ozeromer1111/hellen-example/docs/without-headers.png

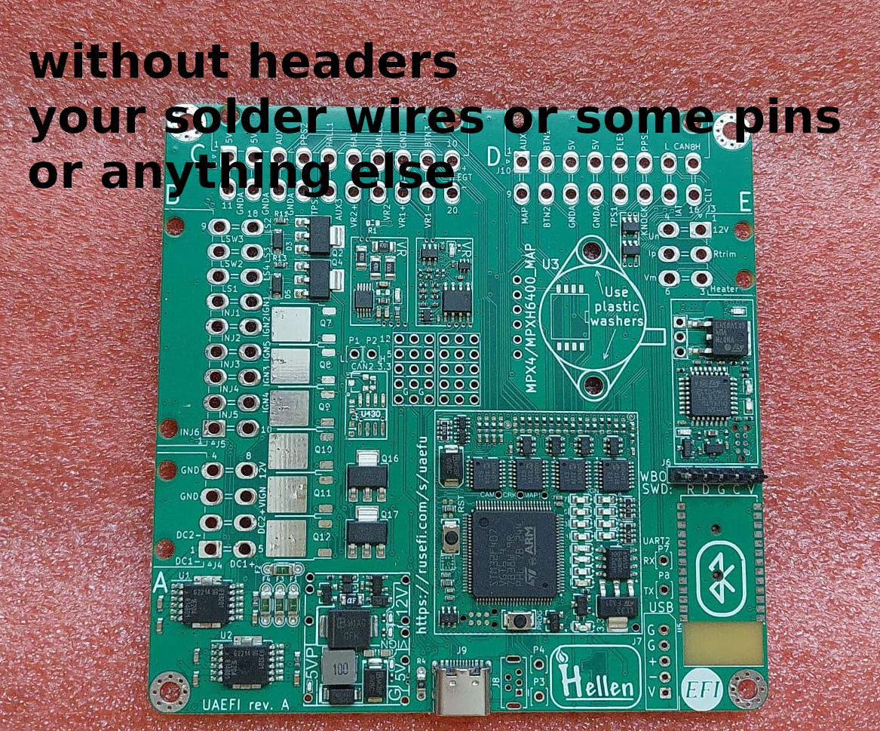
docs/without-headers.png
