ozeromer1111/hellen-example/docs/with-crimp-kit.jpg

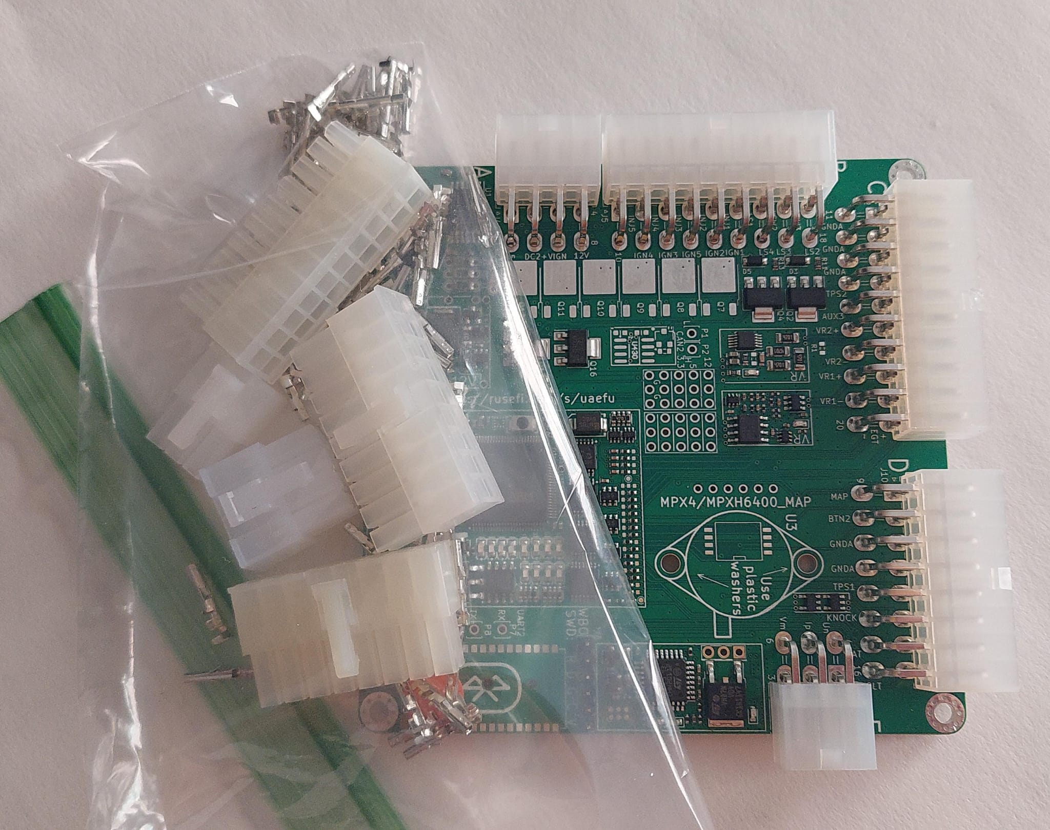
docs/with-crimp-kit.jpg
