ozeromer1111/hellen-example/boards/stabildaytona-v1/board/misc/stabildaytona-v1-bottom.png

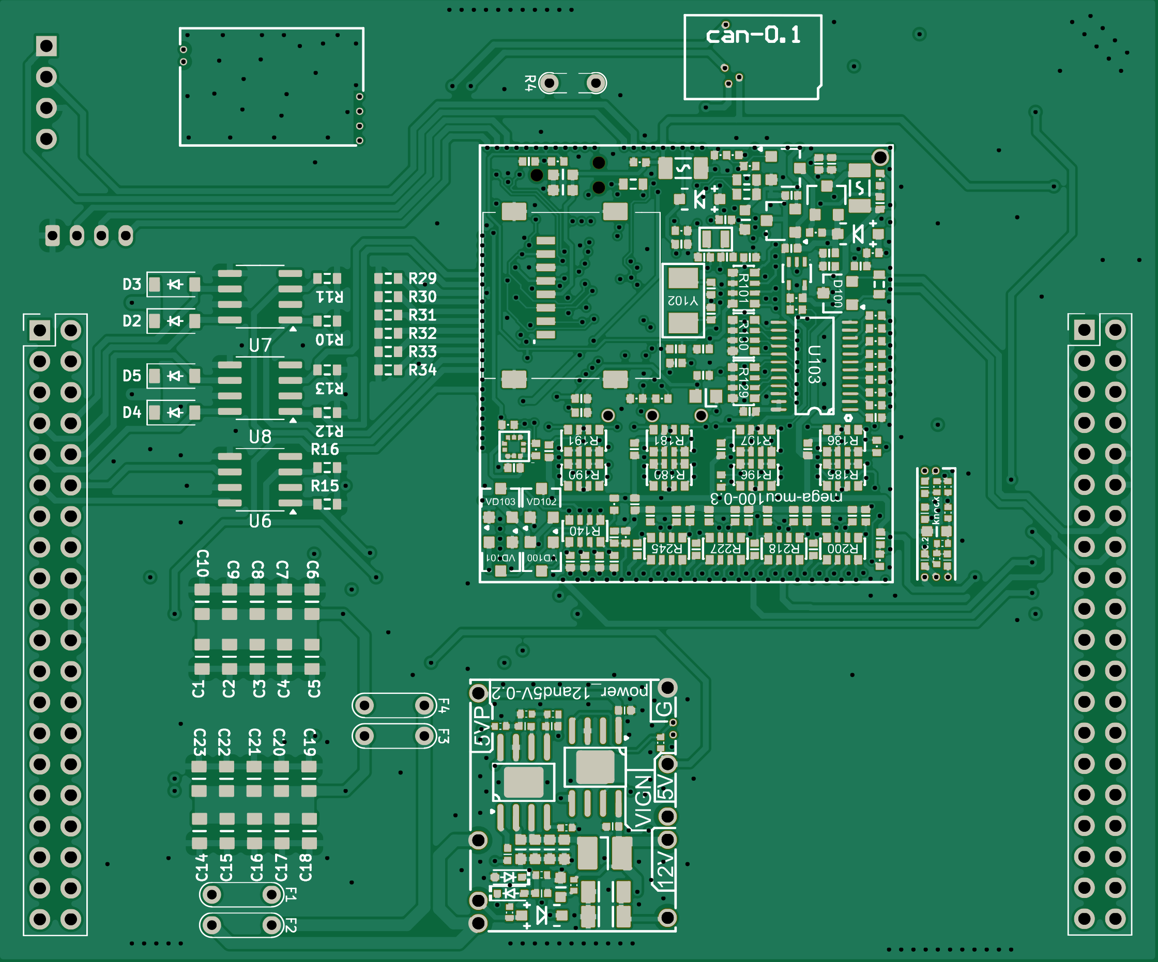
boards/stabildaytona-v1/board/misc/stabildaytona-v1-bottom.png
