ozeromer1111/hellen-example/boards/stabildaytona-v1/board/misc/stabildaytona-v1-top.png

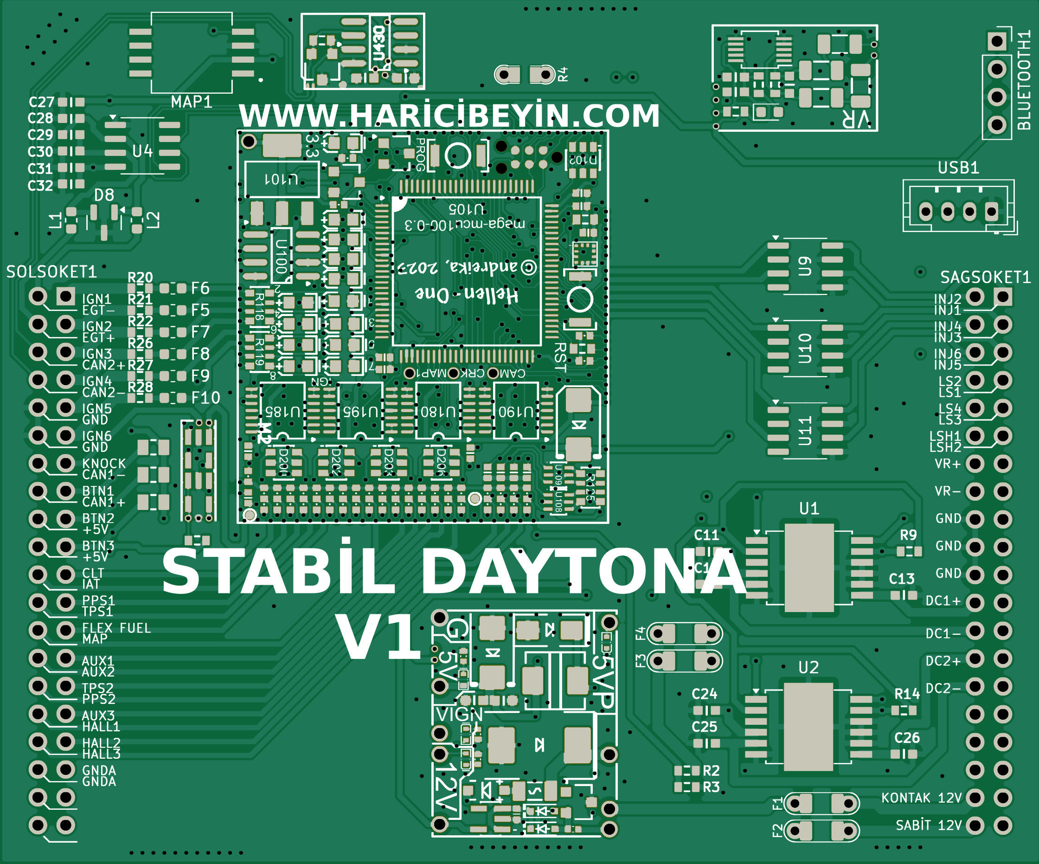
boards/stabildaytona-v1/board/misc/stabildaytona-v1-top.png
