ozeromer1111/hellen-example/boards/stabildaytona-v1/board/stabildaytona-v1.png

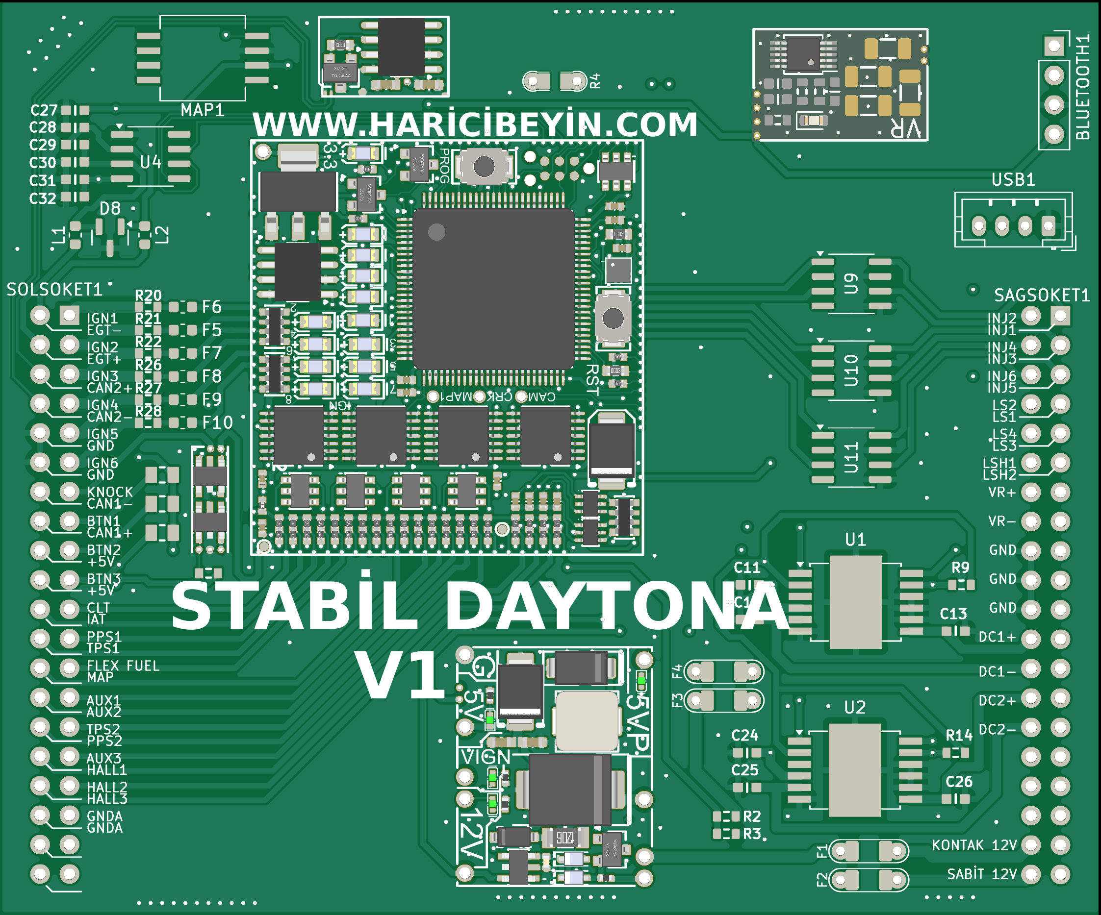
boards/stabildaytona-v1/board/stabildaytona-v1.png
