ozeromer1111/hellen-example/boards/uaefi-a/board/misc/uaefi-a-outline.png

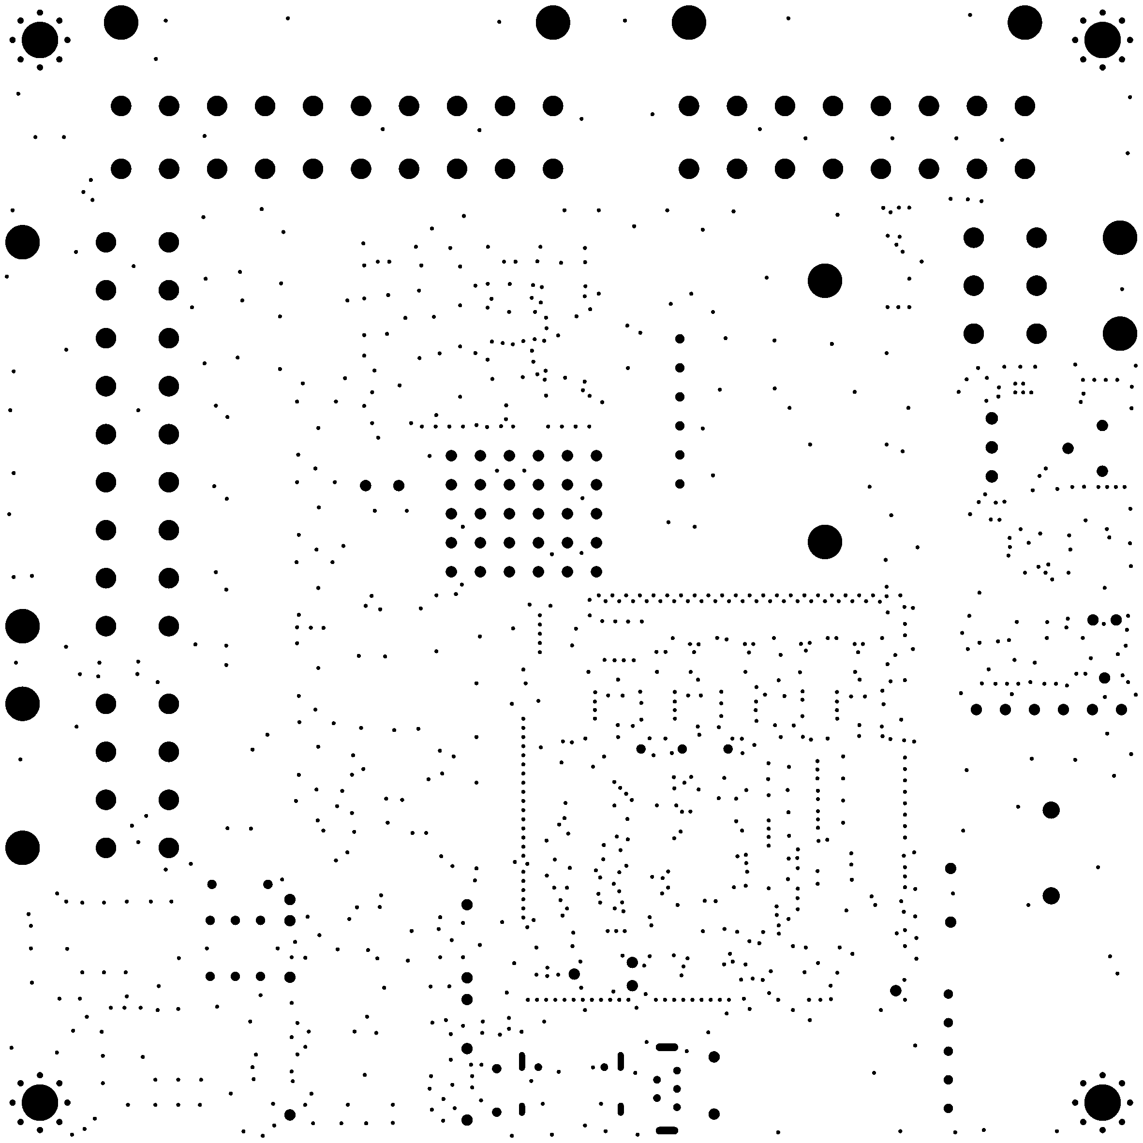
boards/uaefi-a/board/misc/uaefi-a-outline.png
