ozeromer1111/hellen-example/boards/uaefi-a/board/uaefi-a.png

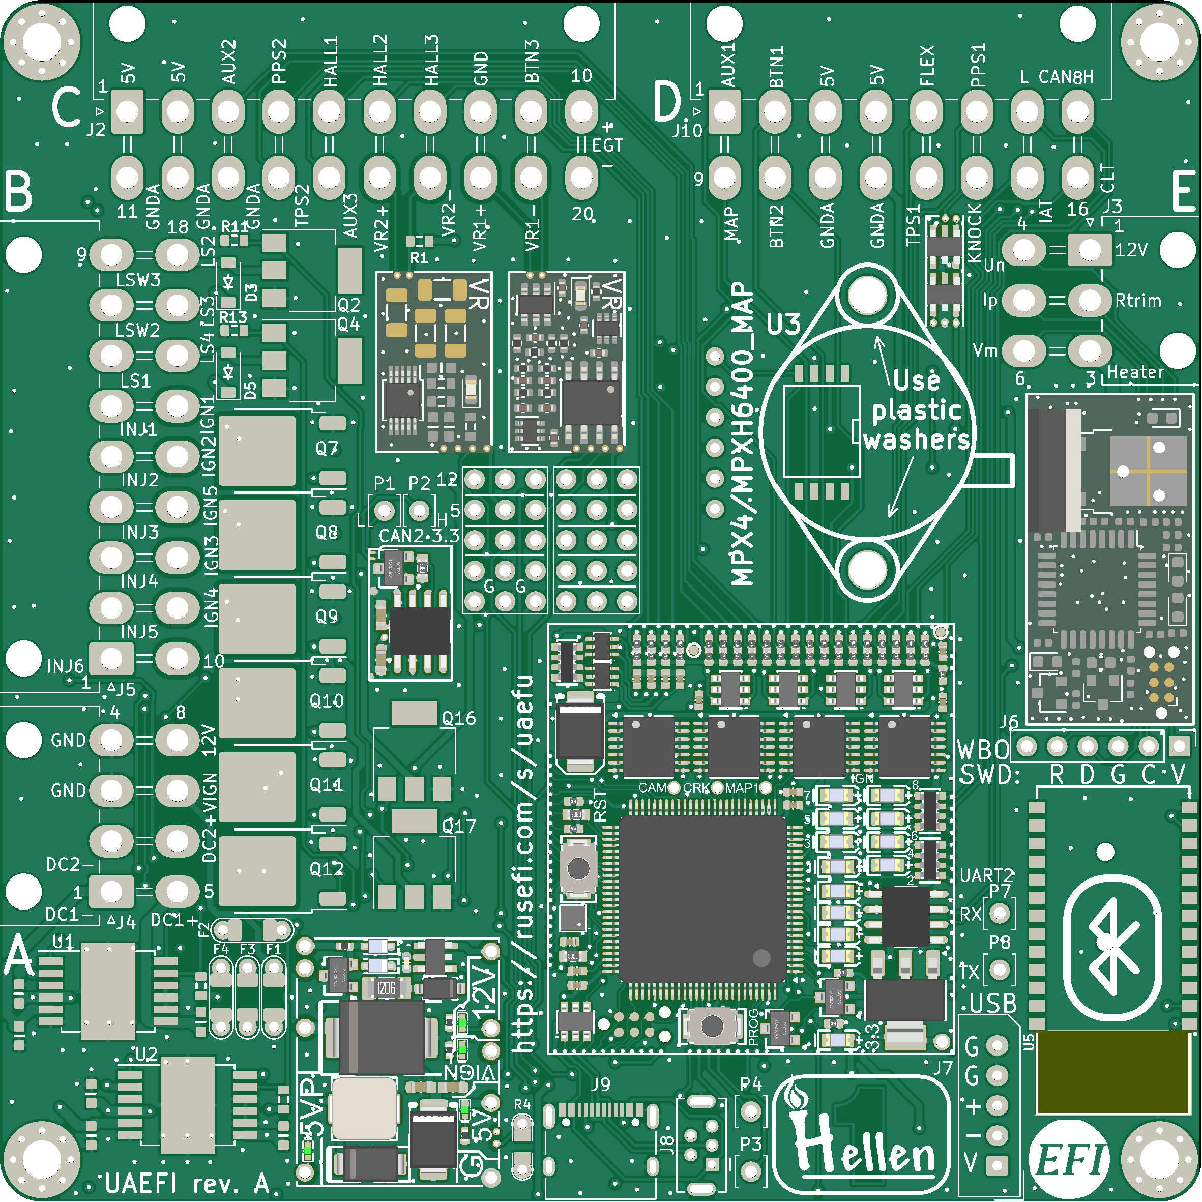
boards/uaefi-a/board/uaefi-a.png
