ozeromer1111/hellen-example/boards/uaefi-b/board/misc/uaefi-b-bottom.png

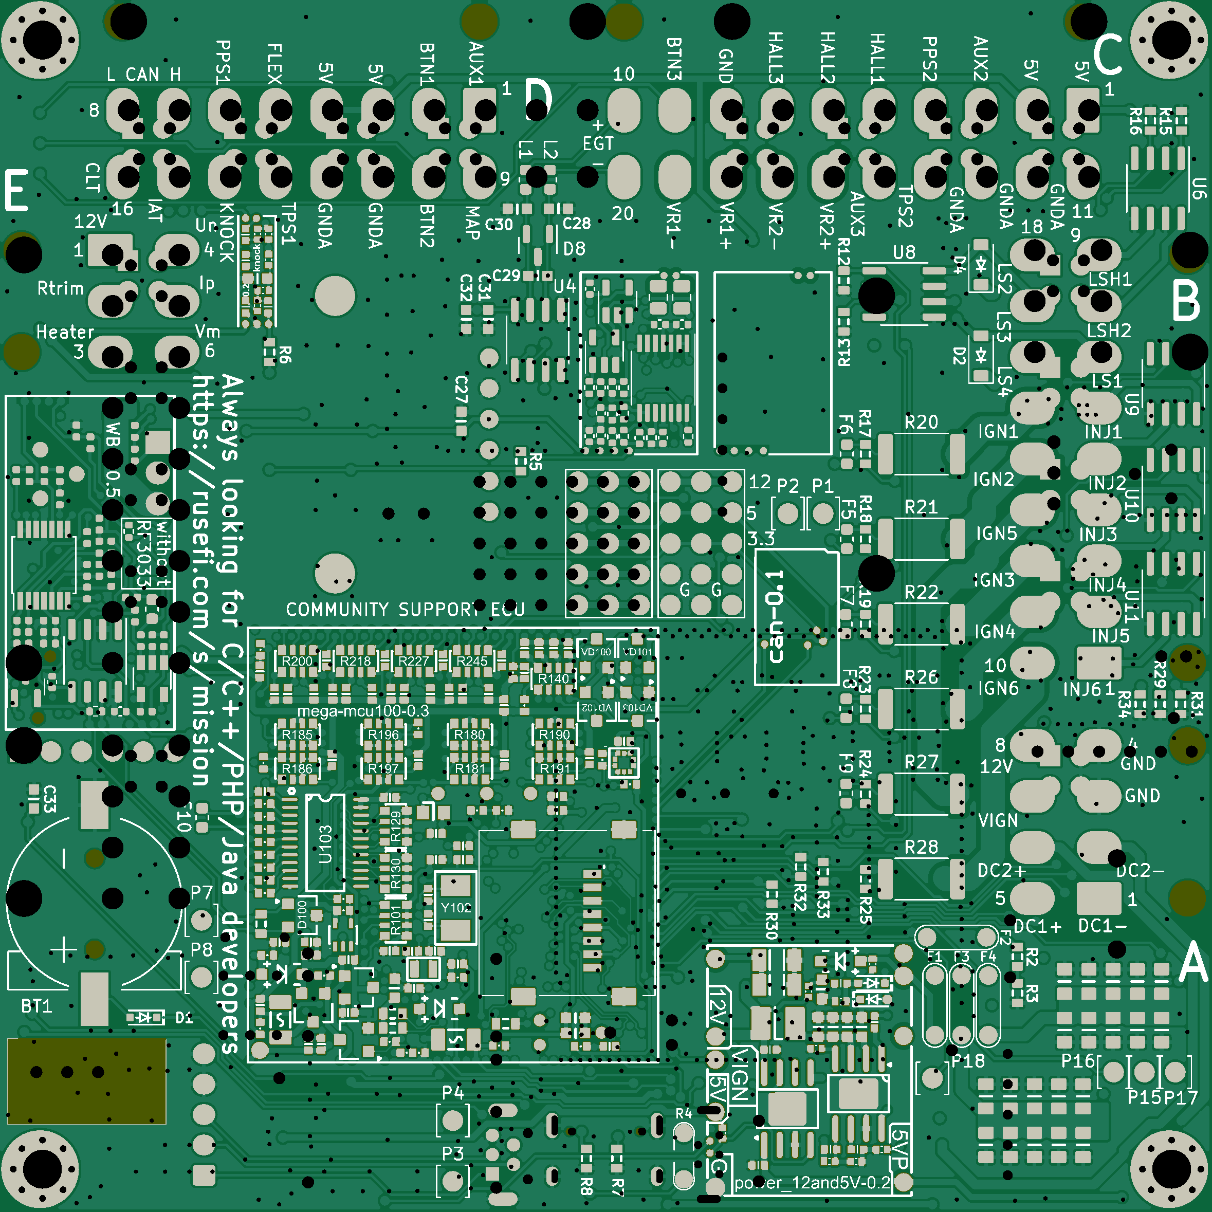
boards/uaefi-b/board/misc/uaefi-b-bottom.png
