ozeromer1111/hellen-example/boards/uaefi-b/board/misc/uaefi-b-top.png

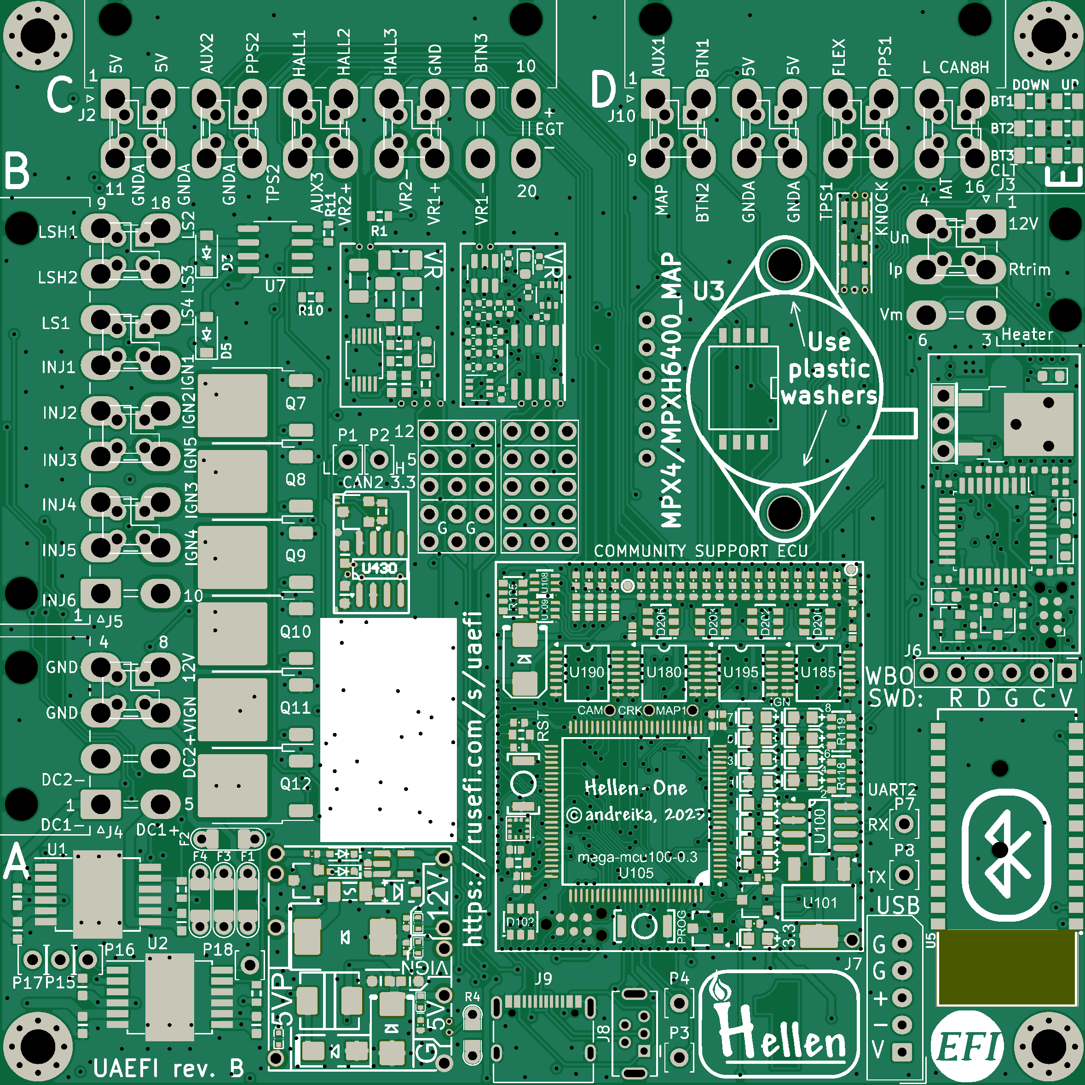
boards/uaefi-b/board/misc/uaefi-b-top.png
