ozeromer1111/hellen-example/boards/uaefi-b/board/uaefi-b.png

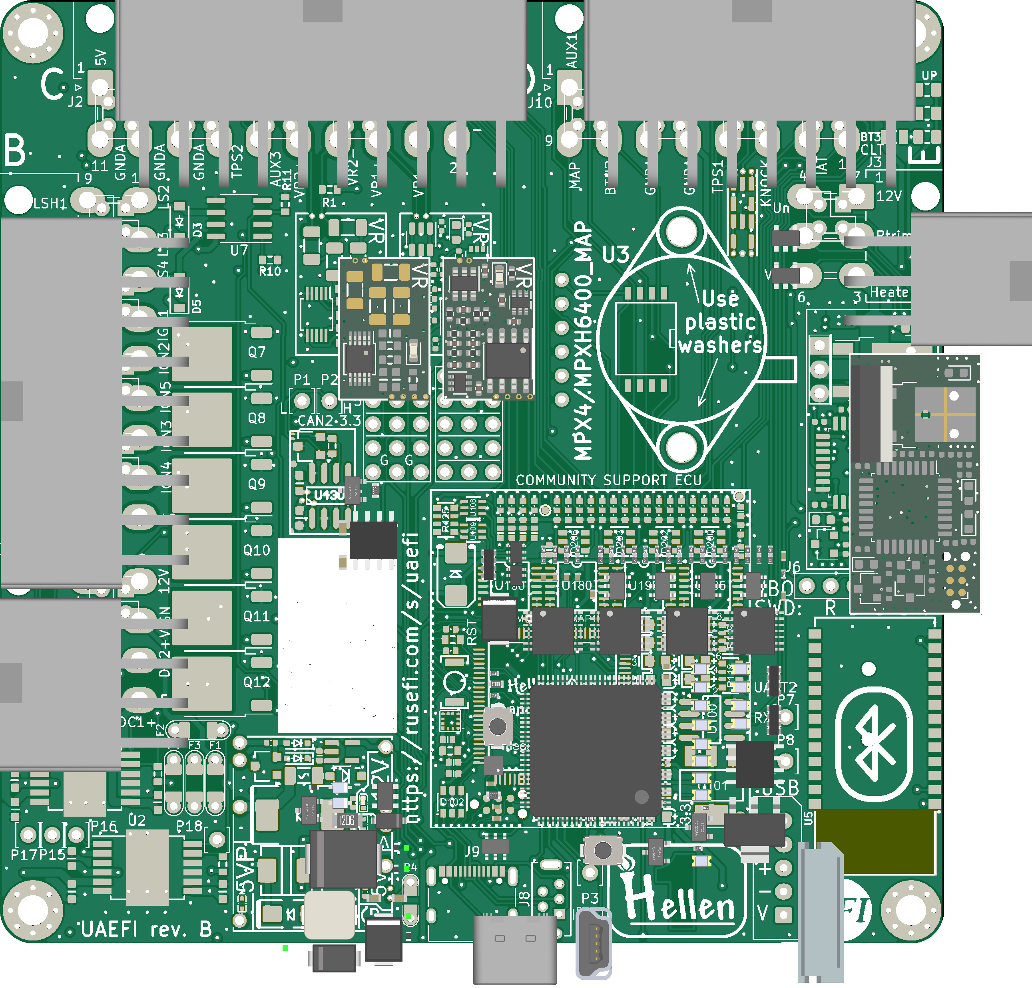
boards/uaefi-b/board/uaefi-b.png
