ozeromer1111/hellen-example/boards/uaefi-c/board/misc/uaefi-c-bottom.png

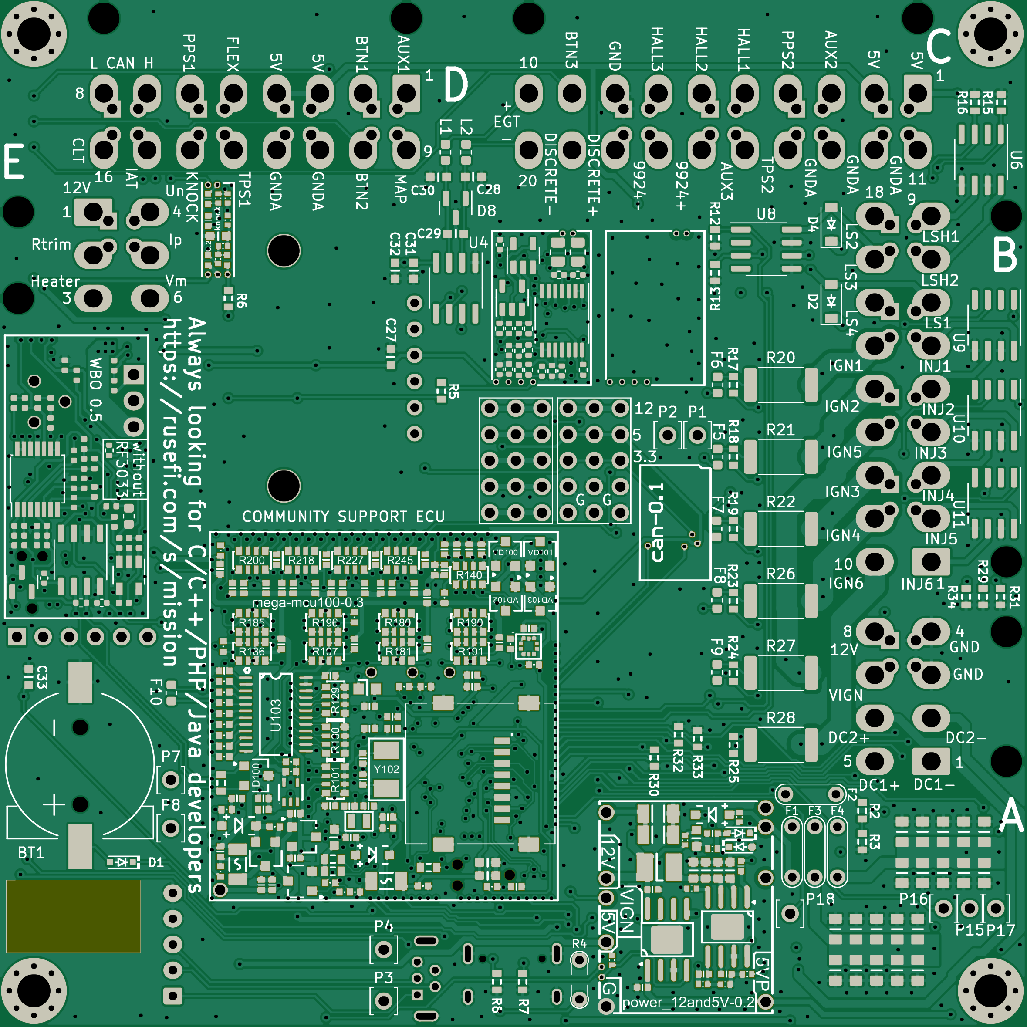
boards/uaefi-c/board/misc/uaefi-c-bottom.png
