ozeromer1111/hellen-example/boards/uaefi-d/board/uaefi-d.png

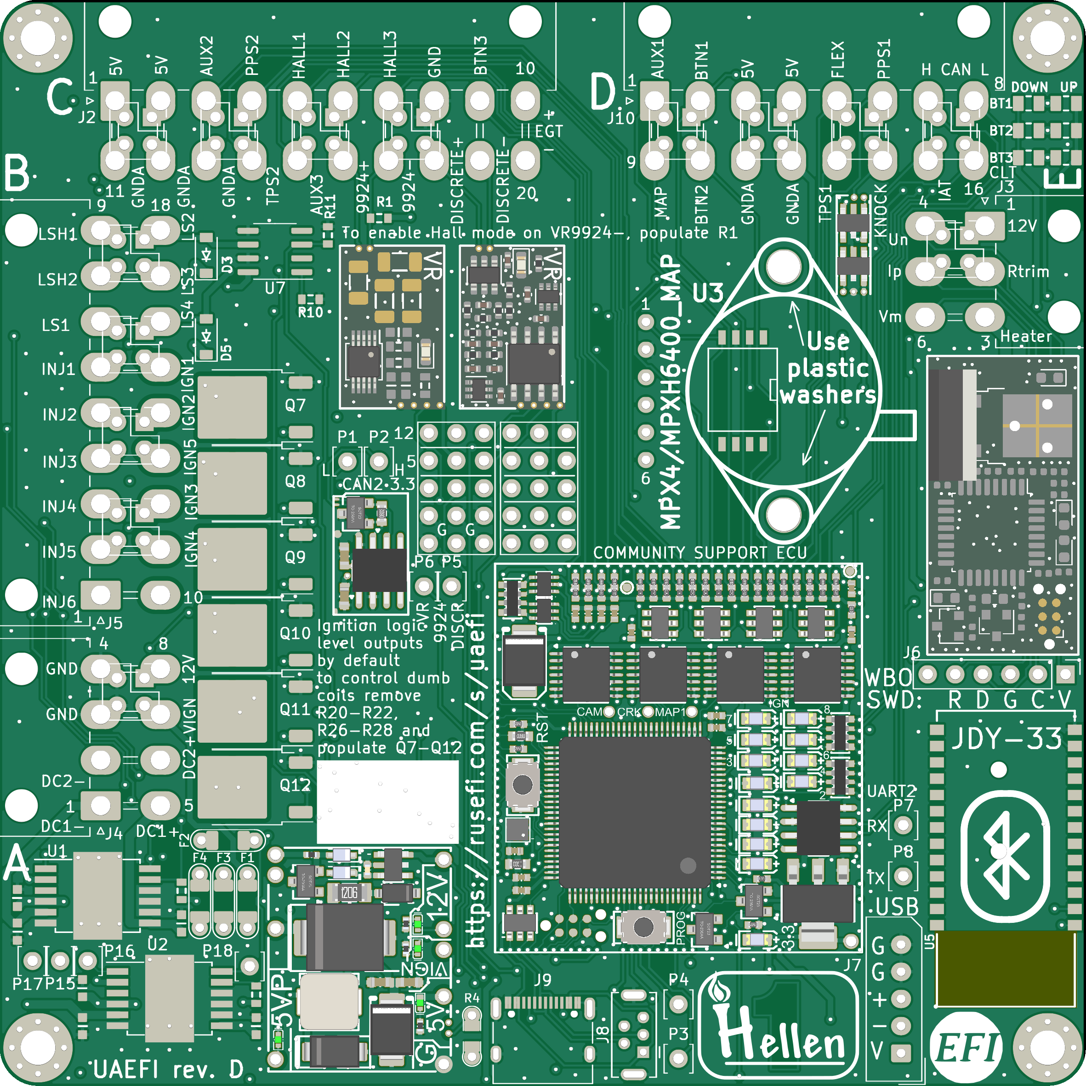
boards/uaefi-d/board/uaefi-d.png
