ozeromer1111/hellen-example/docs/base-bottom.jpg

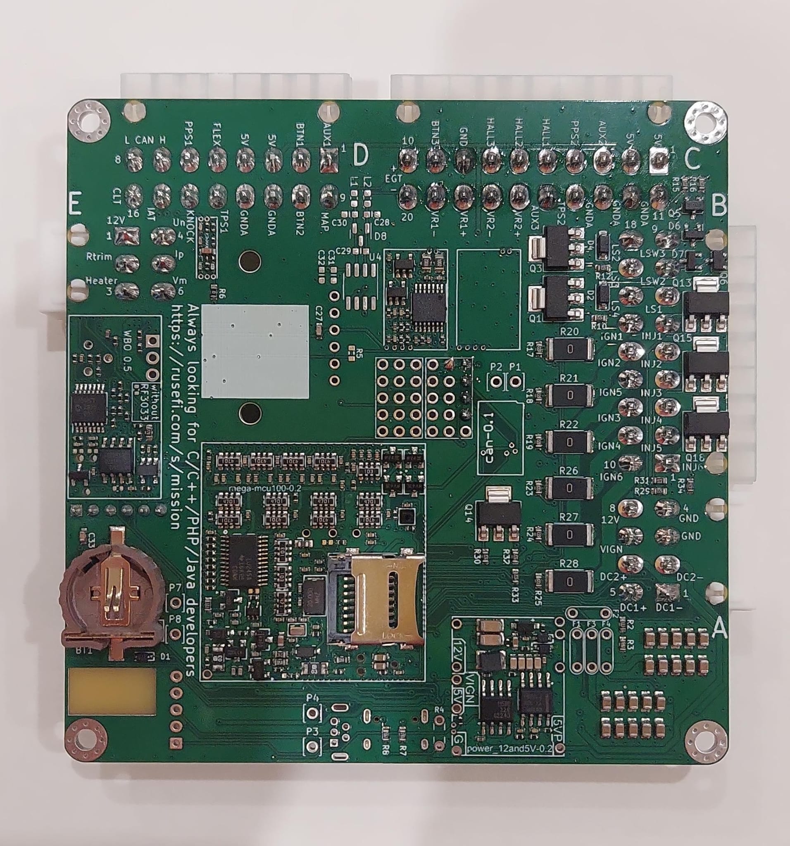
docs/base-bottom.jpg
