ozeromer1111/hellen-example/docs/base-top.jpg

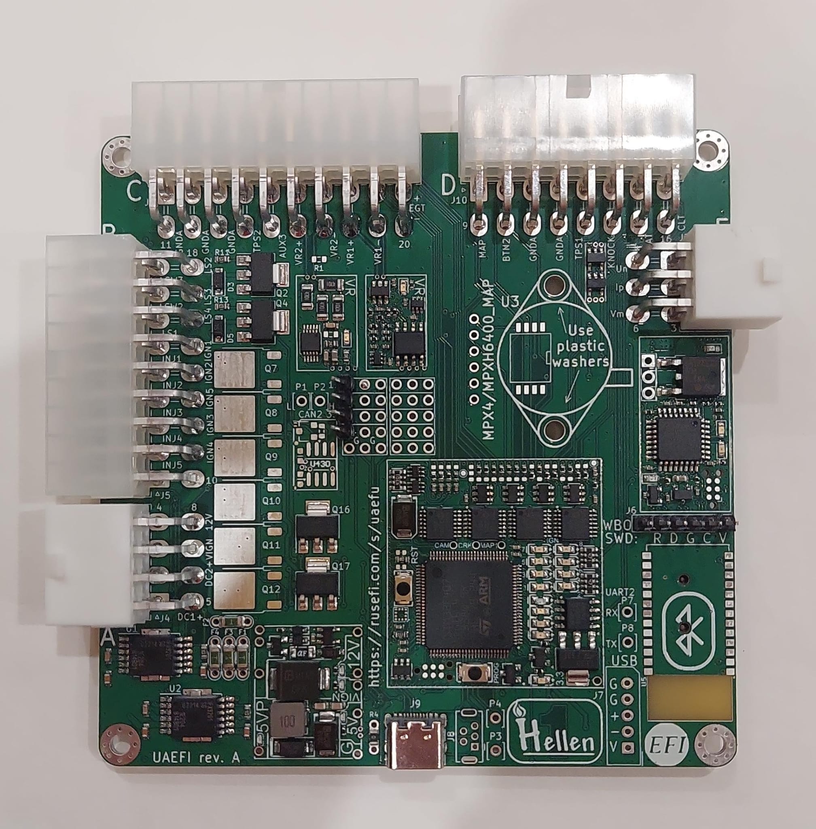
docs/base-top.jpg
