ozeromer1111/hellen-example/docs/orange-150.jpg

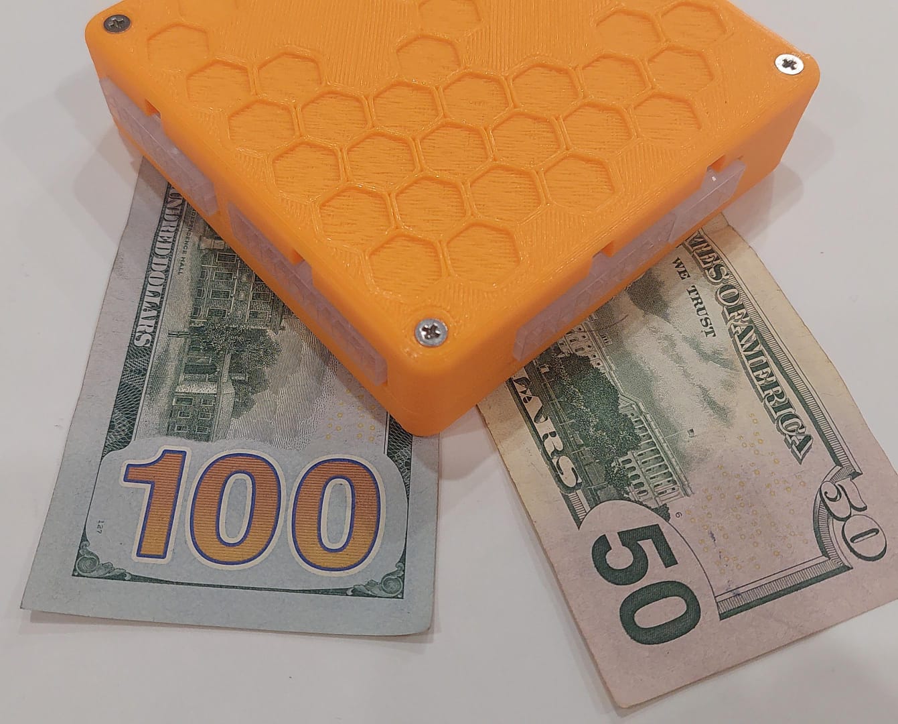
docs/orange-150.jpg
