ozeromer1111/hellen-example/docs/orange.jpg

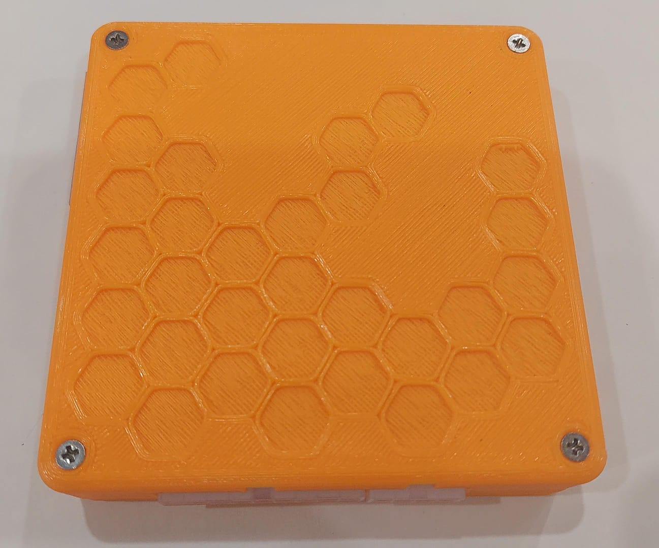
docs/orange.jpg
