ozeromer1111/hellen-example/docs/premium-bottom.jpg

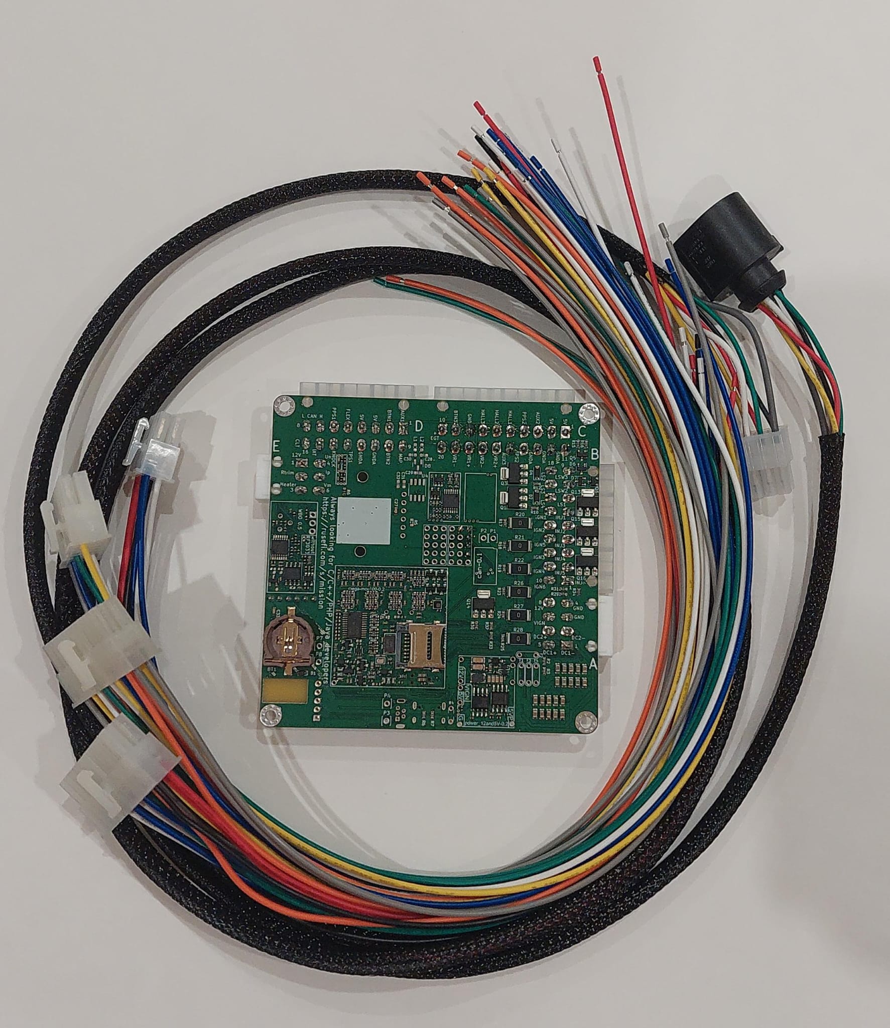
docs/premium-bottom.jpg
