ozeromer1111/hellen-example/docs/premium-top.jpg

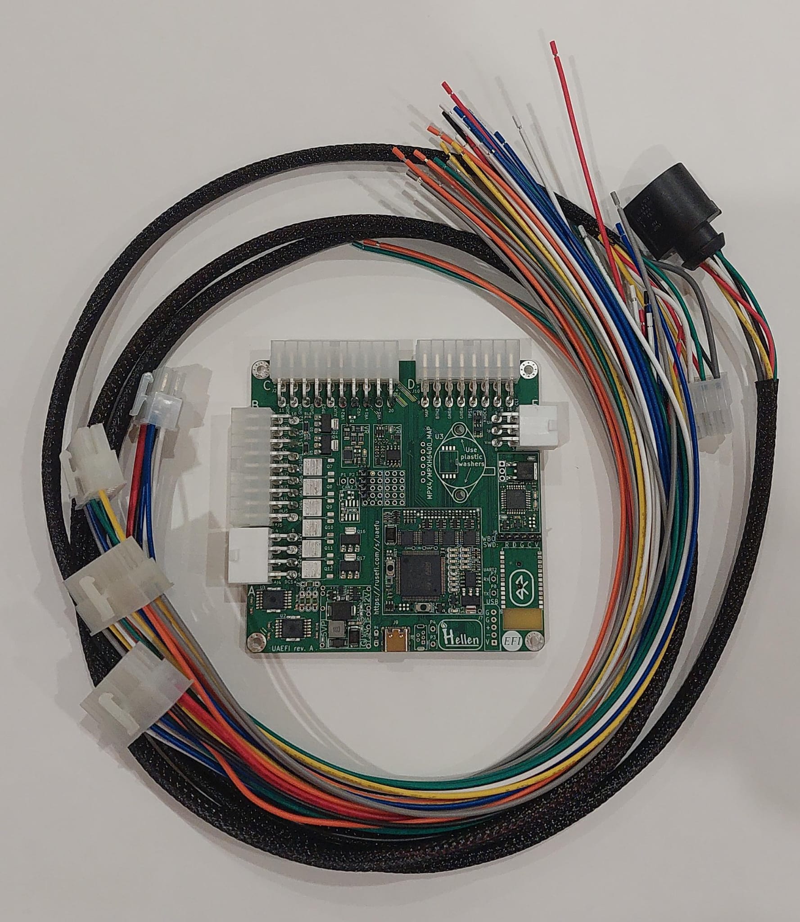
docs/premium-top.jpg
