ozeromer1111/hellen-example/docs/uaefi-a-top-high-res.jpg

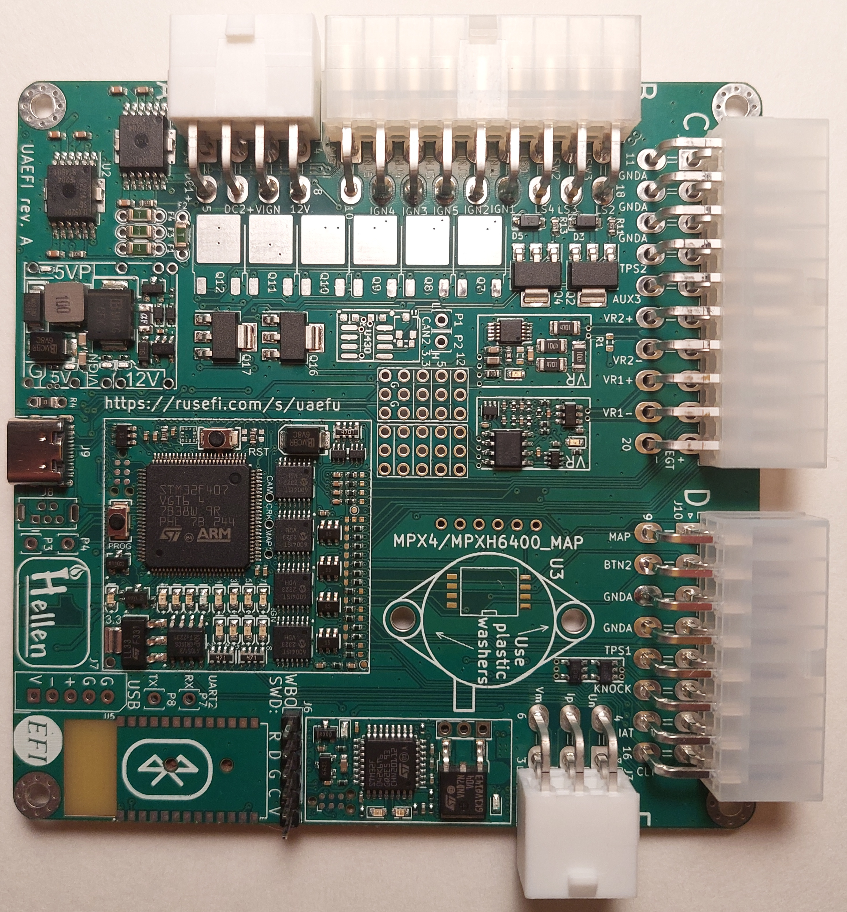
docs/uaefi-a-top-high-res.jpg
