ozeromer1111/hellen-example/docs/with-headers.png

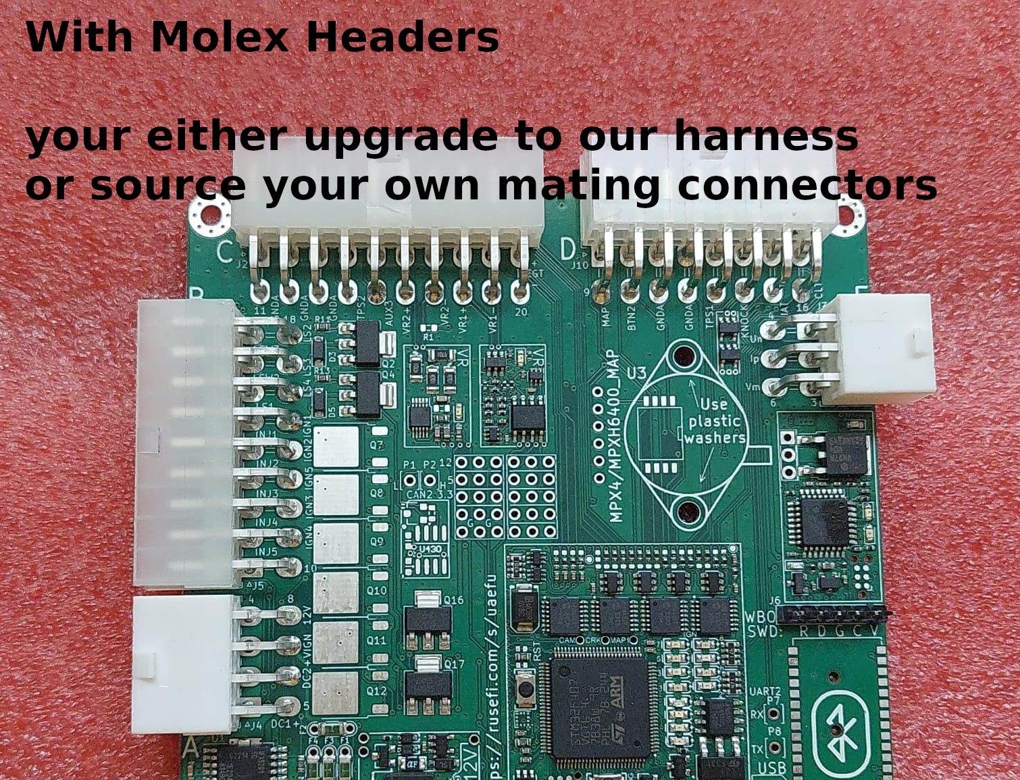
docs/with-headers.png
