ozeromer1111/hellen-example/boards/uaefi-a/board/misc/uaefi-a-components.png

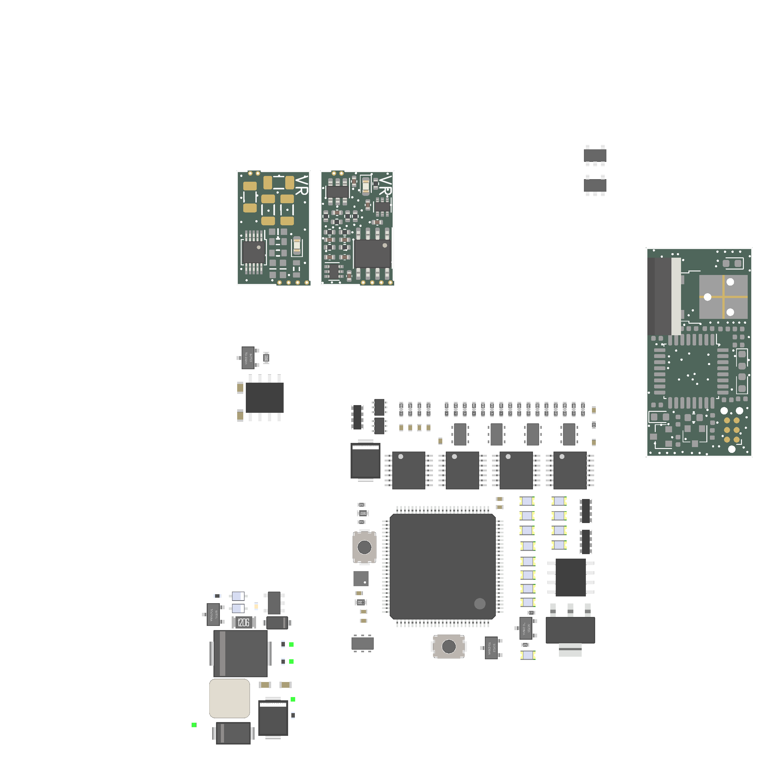
boards/uaefi-a/board/misc/uaefi-a-components.png
