ozeromer1111/hellen-example/boards/uaefi-b/board/misc/uaefi-b-components.png

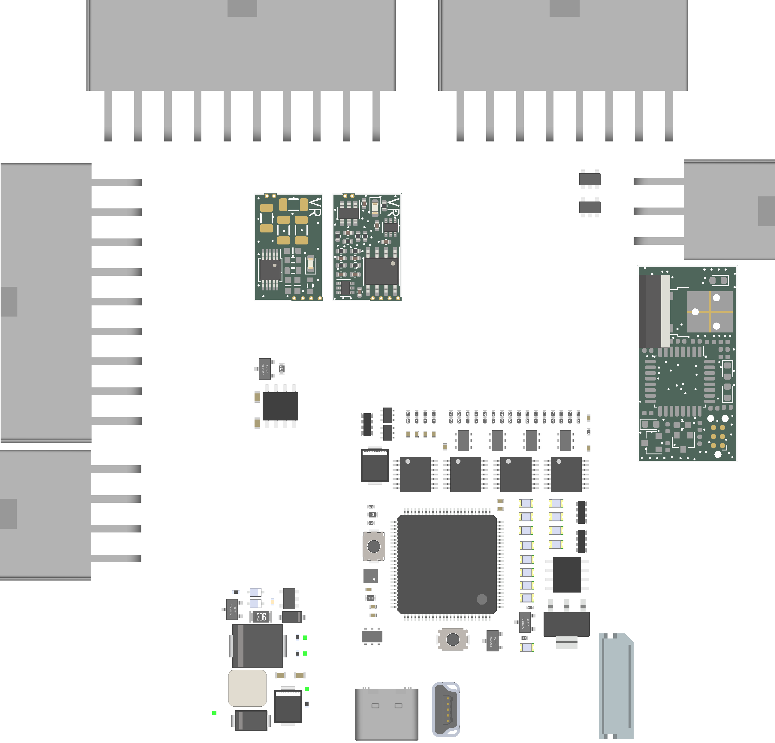
boards/uaefi-b/board/misc/uaefi-b-components.png
