ozeromer1111/hellen-example/3D models/User Library-UE25BE5510H.STEP

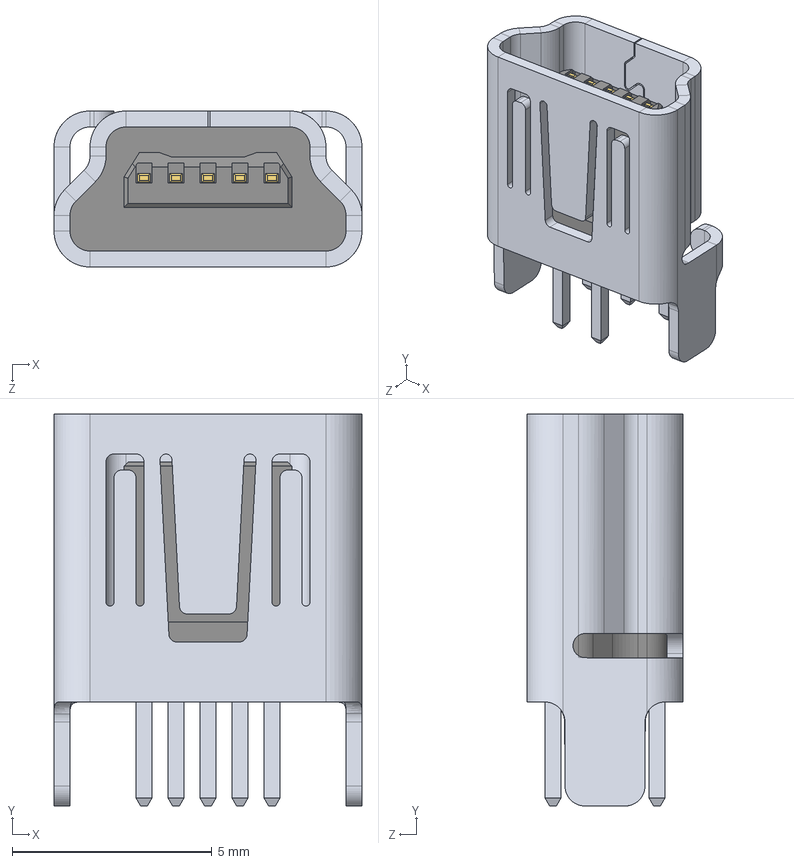
[picture p43: CAD file, 2024-12-31]
3D models/User Library-UE25BE5510H.STEP
7.70 x 9.80 x 3.90 mm
