ozeromer1111/hellen-example/3D models/User Library-USB-B-Vert-MINI.STEP

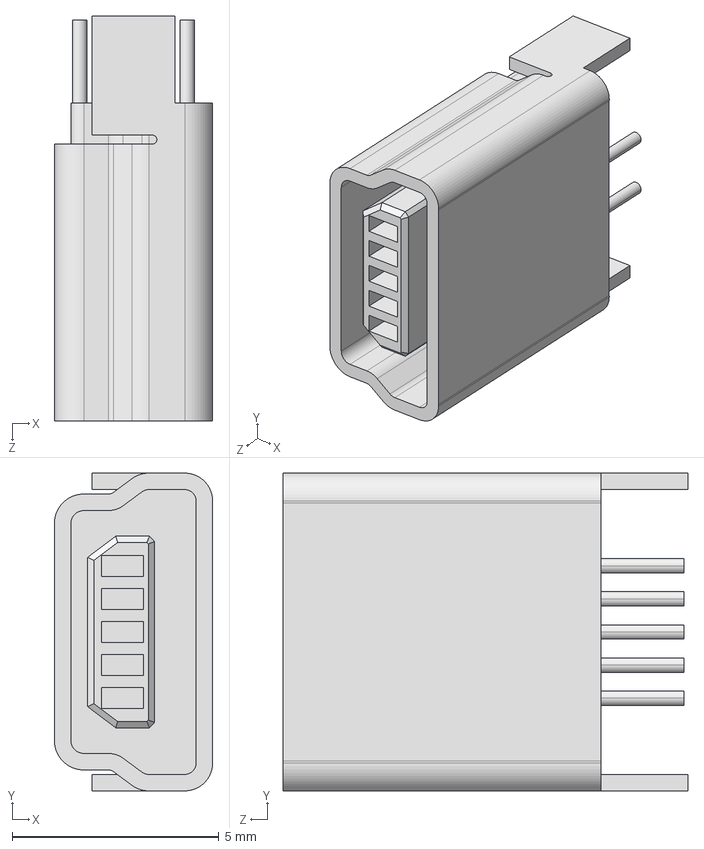
[picture p44: CAD file, 2024-12-31]
3D models/User Library-USB-B-Vert-MINI.STEP
3.83 x 7.69 x 9.80 mm
