ozeromer1111/hellen-example/3D models/User Library-USB - C.STEP

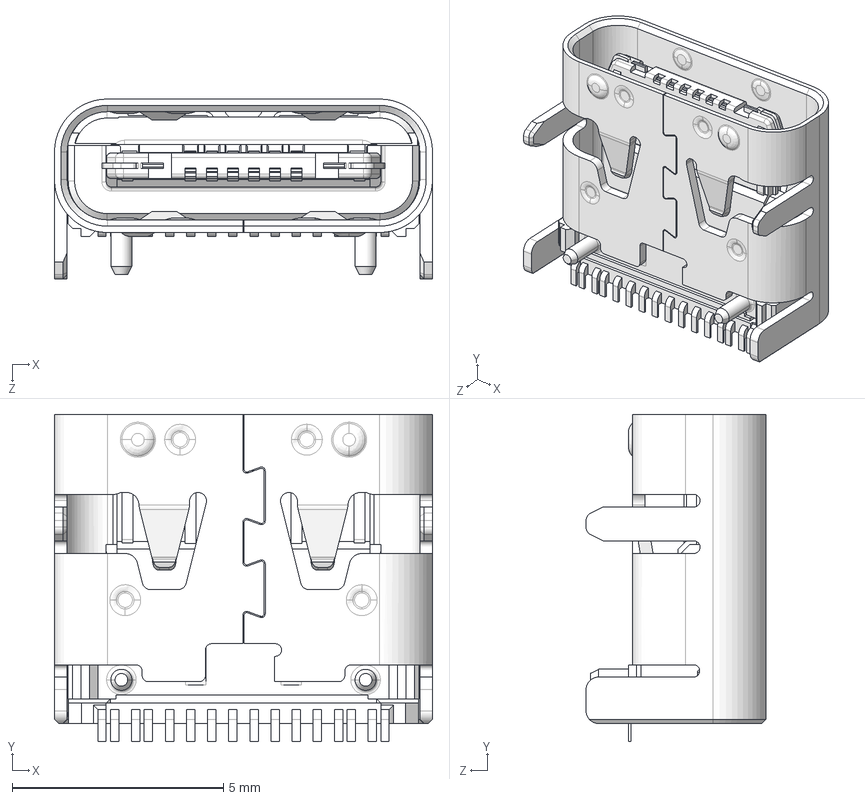
[picture p45: CAD file, 2024-12-31]
3D models/User Library-USB - C.STEP
8.95 x 7.75 x 4.26 mm
