ozeromer1111/hellen-example/3D models/022035055.stp

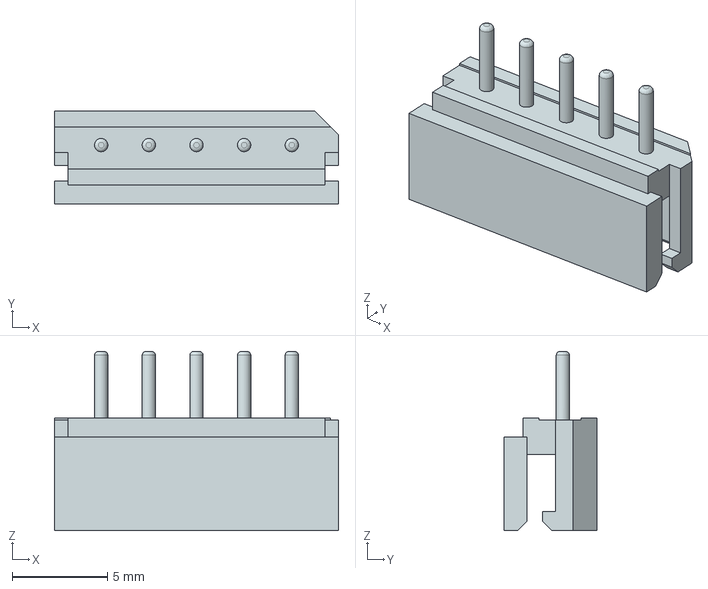
[picture p46: CAD file, 2024-12-31]
3D models/022035055.stp
14.9 x 4.90 x 9.40 mm
