ozeromer1111/hellen-example/3D models/039301060.stp

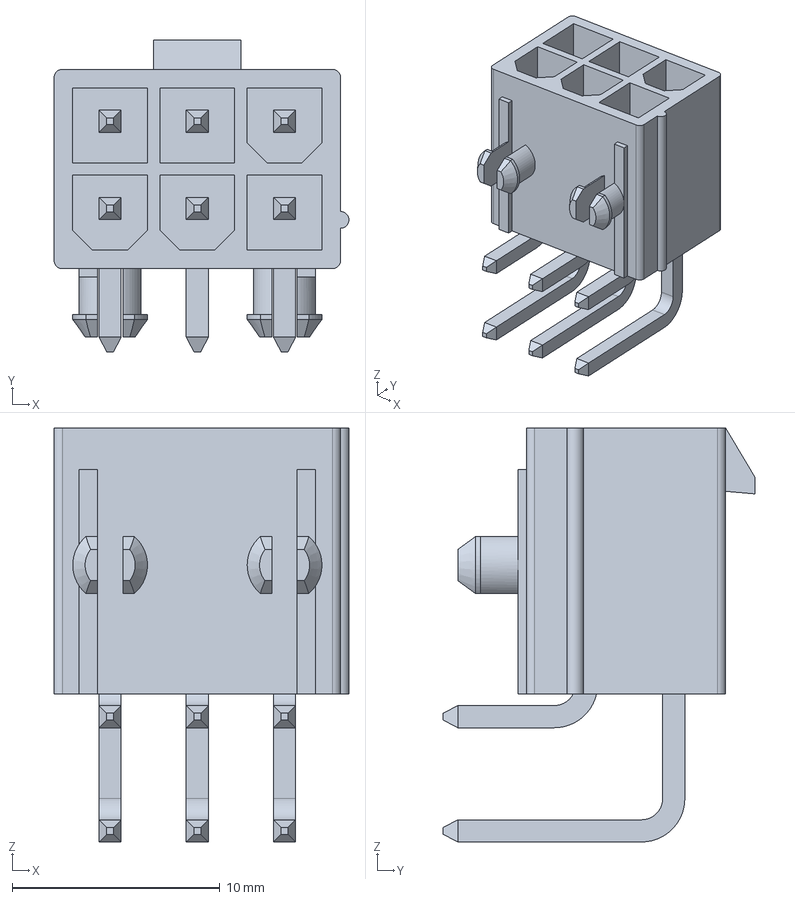
[picture p47: CAD file, 2024-12-31]
3D models/039301060.stp
14.2 x 15.0 x 19.9 mm
