ozeromer1111/hellen-example/3D models/039301200.stp

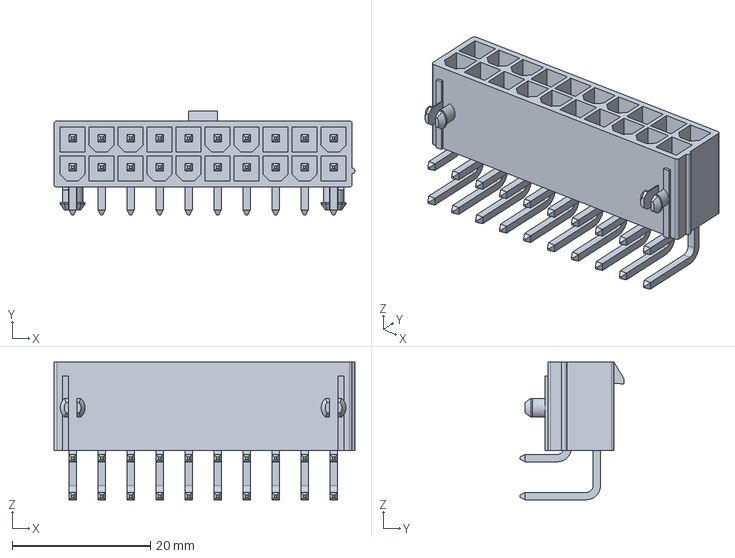
[picture p48: CAD file, 2024-12-31]
3D models/039301200.stp
43.6 x 15.0 x 19.9 mm
