ozeromer1111/hellen-example/3D models/039301180.stp

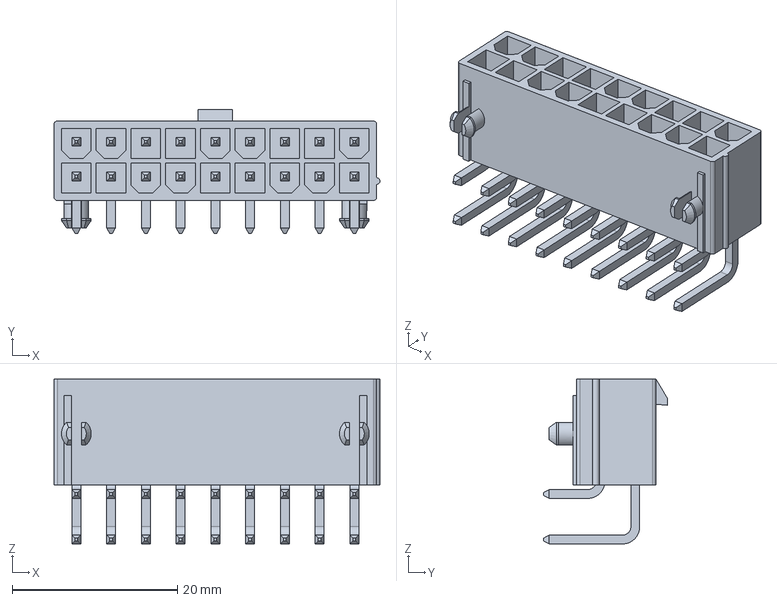
[picture p49: CAD file, 2024-12-31]
3D models/039301180.stp
39.4 x 15.0 x 19.9 mm
