ozeromer1111/hellen-example/3D models/039301160.stp

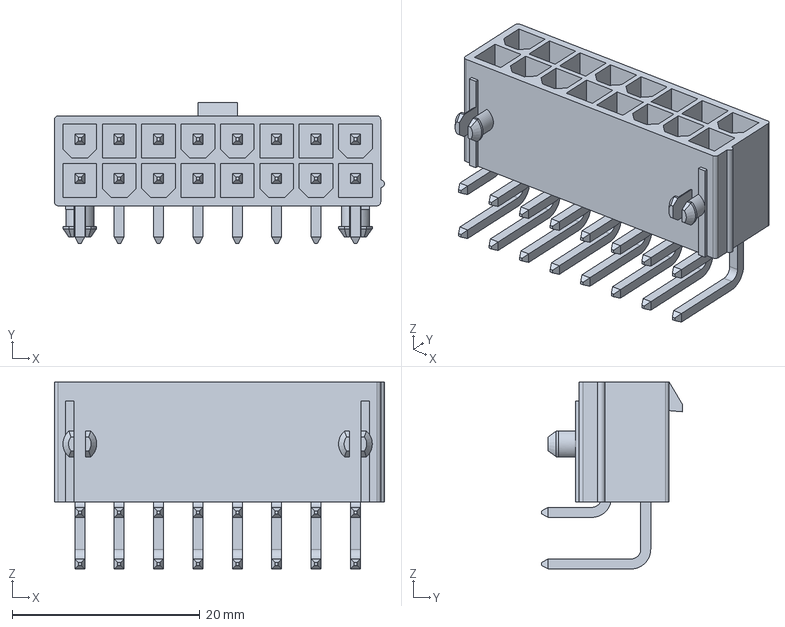
[picture p50: CAD file, 2024-12-31]
3D models/039301160.stp
35.2 x 15.0 x 19.9 mm
