ozeromer1111/hellen-example/3D models/039301080.stp

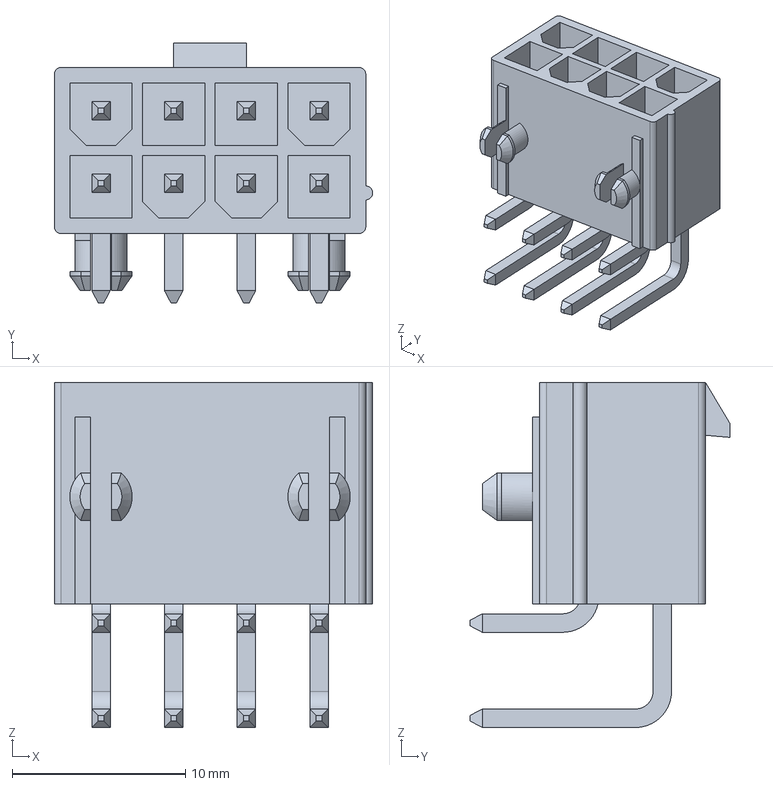
[picture p51: CAD file, 2024-12-31]
3D models/039301080.stp
18.4 x 15.0 x 19.9 mm
