ozeromer1111/hellen-example/3D models/1054500101.stp

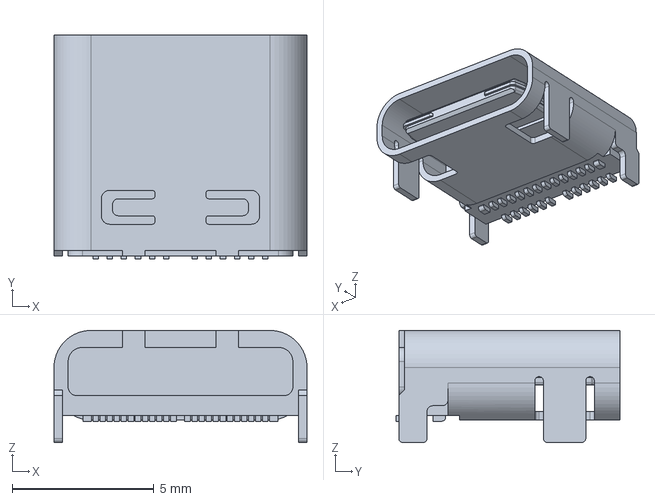
[picture p52: CAD file, 2024-12-31]
3D models/1054500101.stp
8.94 x 7.90 x 3.96 mm
