ozeromer1111/hellen-example/boards/stabildaytona-v1/frame/daytona-schematic.pdf

https://rusefi.com/s/uaefi
Id: 1/9 Title: UAEFI File: stabildaytona.kicad_sch Sheet: / rusEFI.com



Id: 3/9 Title: UAEFI File: LS4.kicad_sch Sheet: /LS/ rusEFI.com




Id: 8/9 Title: UAEFI File: MAP.kicad_sch Sheet: /MAP/ rusEFI.com


Id: 9/9 Title: UAEFI File: IGN6.kicad_sch Sheet: /Ignition/ rusEFI.com


Id: 9/9 Title: UAEFI File: egt.kicad_sch Sheet: /EGT/ rusEFI.com GND
