ozeromer1111/hellen-example/boards/uaefi-a/frame/efi-schematic.pdf

LS & HS outputs Discrete inputs

Analog/digital Heater negative Power GND

3V3 12 GND 13 EN 15 ALED 16 STAT 17 RXD 2

enable the CAN WAKEUP
input will be unavailable.

use ADC3 for receiving
the analog signal VR1
instead of the knock
signal

https://rusefi.com/s/h112-17
File: uaefi.kicad_sch Sheet: / rusEFI.com



File: LS4.kicad_sch Sheet: /Low Side 2A/ rusefi.com

Id: 3/9 Title: UAEFI Low Side


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


Id: 8/9 Title: File: MAP.kicad_sch Sheet: /MAP/


File: IGN6.kicad_sch Sheet: /Ignition/ rusefi.com

Id: 9/9 Title: UAEFI Ignition


4 SCK 5 ~{CS}6 SO 7 U4 MAX31855KASA DNP

Id: 9/9 Title: File: egt.kicad_sch Sheet: /EGT/


Id: 10/9 Title: UAEFI Injector File: INJ6.kicad_sch Sheet: /Injector/ rusefi.com
