ozeromer1111/hellen-example/boards/uaefi-c/frame/efi-schematic.pdf

Analog/digital Heater negative Power GND

3V3 12 GND 13 EN 15 ALED 16 STAT 17 RXD 2

enable the CAN WAKEUP
input will be unavailable.

analog signal VR-DISCRETE
instead of the knock signal

Hellen-One-PCB-logo

https://rusefi.com/s/uaefi
Id: 1/9 Title: UAEFI File: uaefi.kicad_sch Sheet: / rusEFI.com



File: LS4.kicad_sch Sheet: /LS/ rusefi.com

Id: 3/9 Title: UAEFI Low Side




Id: 8/9 Title: File: MAP.kicad_sch Sheet: /MAP/


File: IGN6.kicad_sch Sheet: /Ignition/ rusefi.com

Id: 9/9 Title: UAEFI Ignition


Id: 9/9 Title: File: egt.kicad_sch Sheet: /EGT/
