ozeromer1111/hellen-example/stabildaytona.kicad_pcb

## KiCad design stabildaytona.kicad_pcb (2025-04-19)

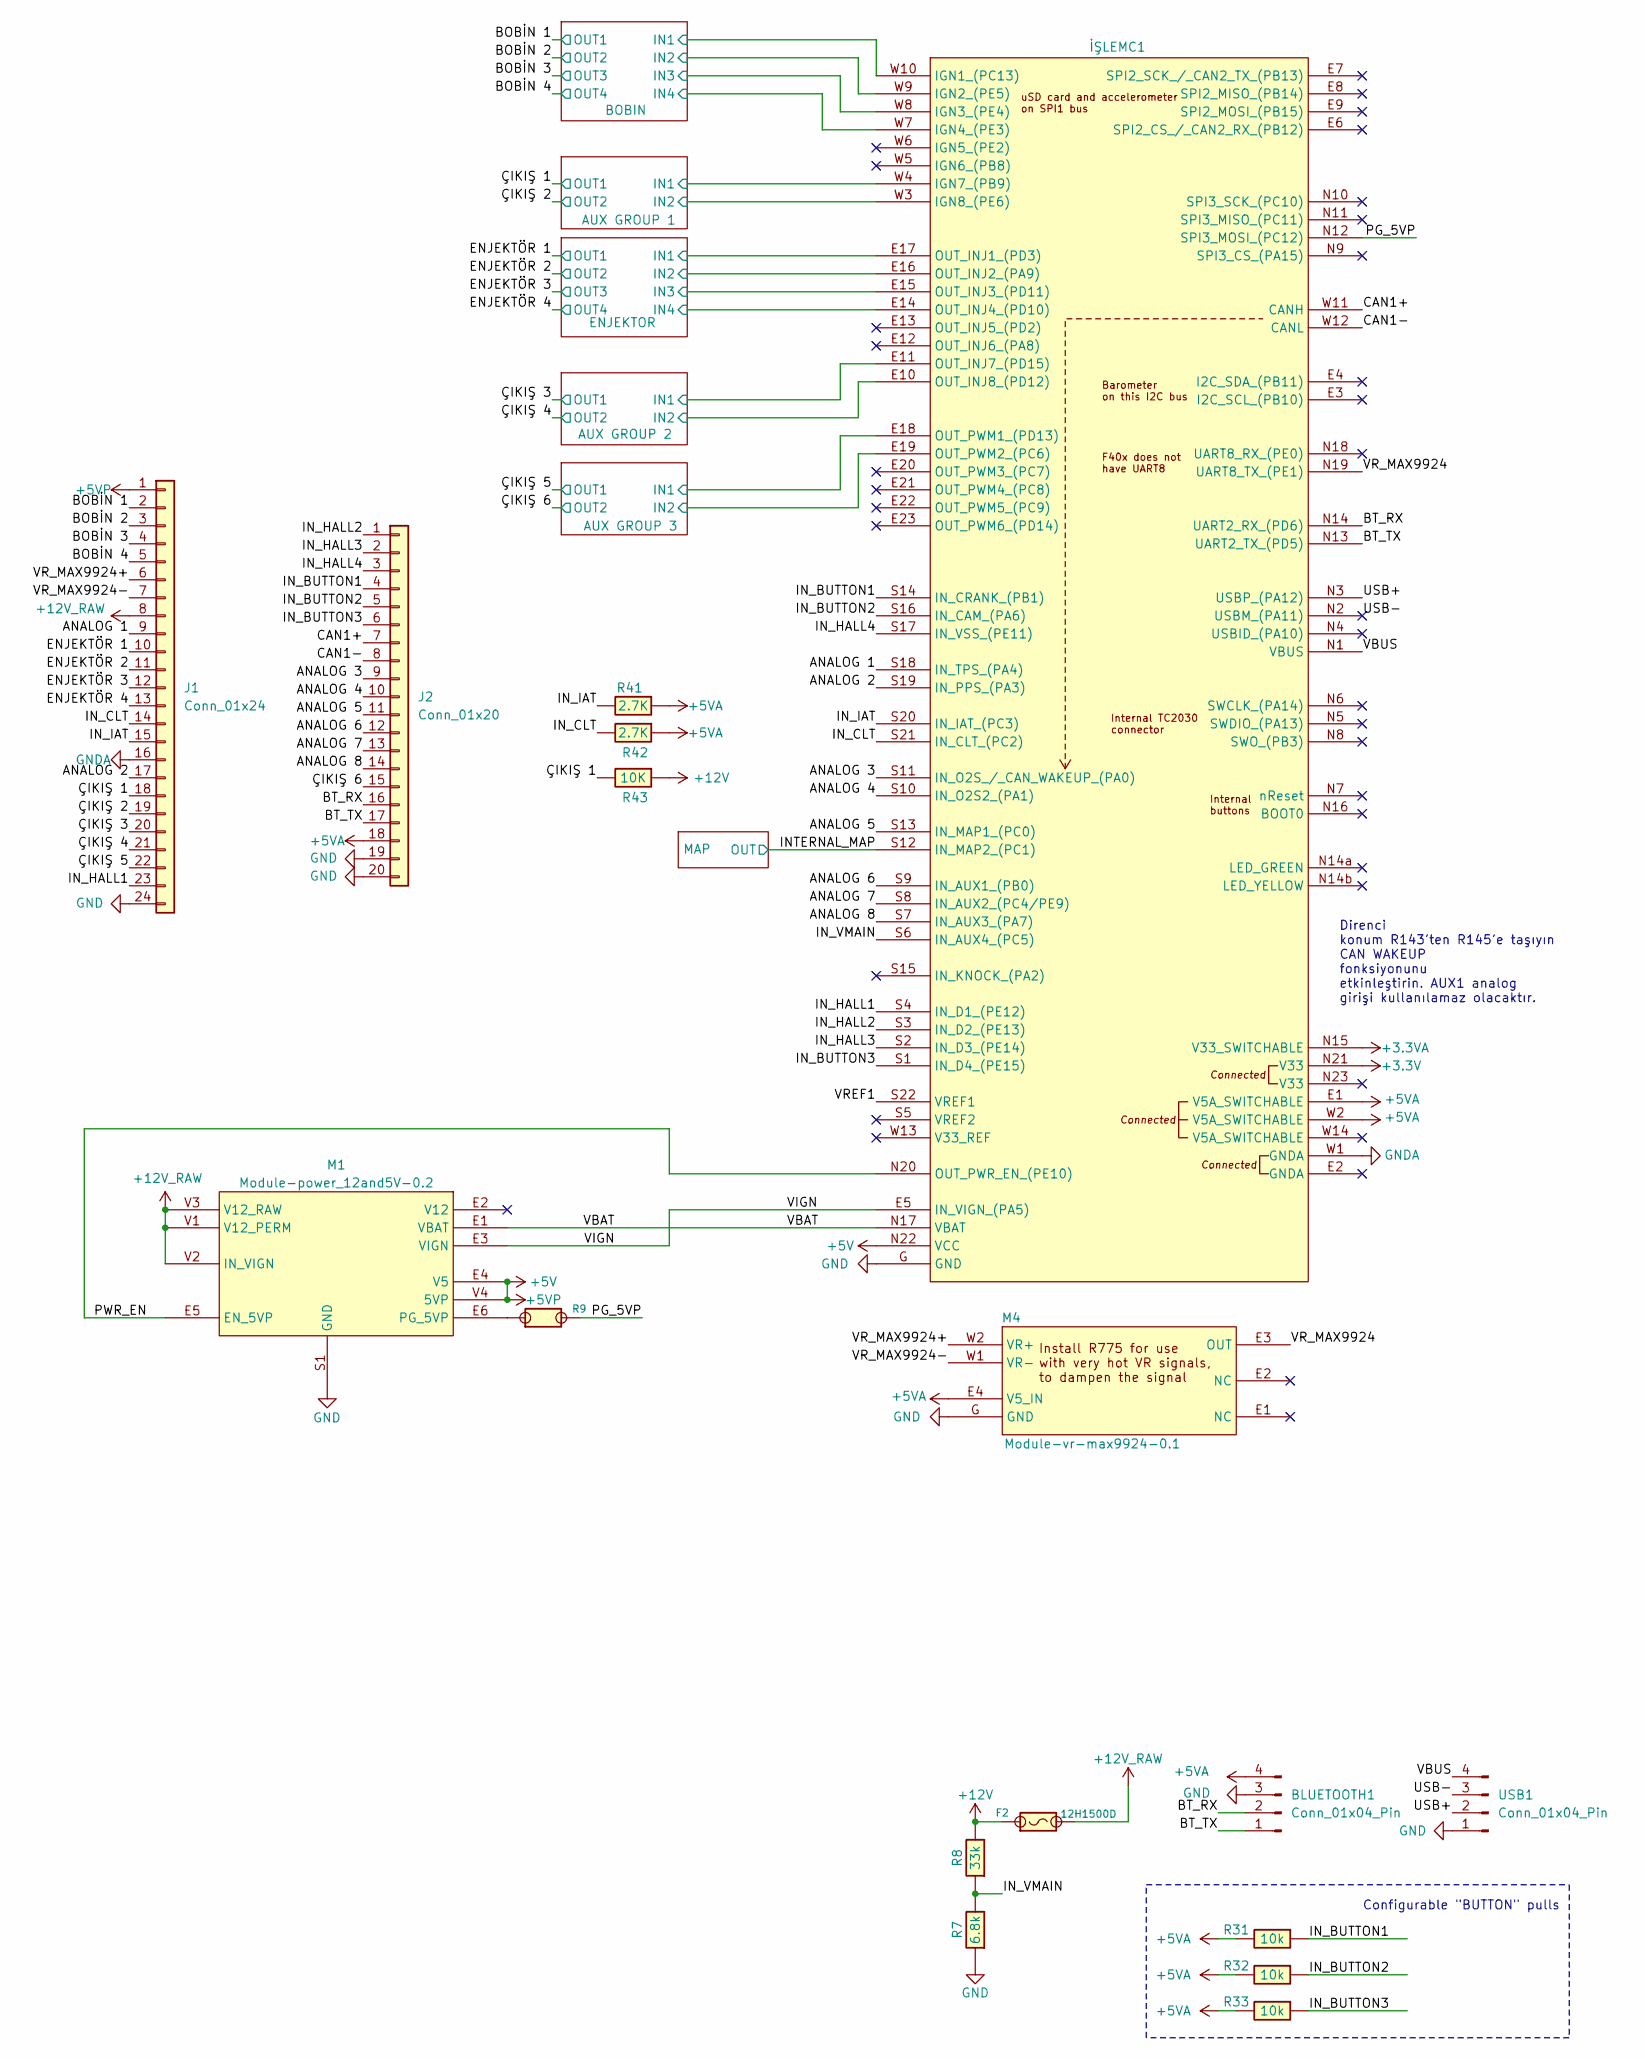
[picture p123: schematic stabildaytona.kicad_sch, UAEFI]

Parts:
BLUETOOTH1: Conn_01x04_Pin; PinSocket_1x04_P2.54mm_Vertical; LCSC C22438154
F2: 12H1500D; PAD-1206-PAD; LCSC C182446
J1: Conn_01x24; 24pin
J2: Conn_01x20; TE_2-826576-0_1x20_P3.96mm_Vertical
M1: Module-power_12and5V-0.2; power_12and5V
M4: Module-vr-max9924-0.1; vr-max9924
R7: 6.8k; R0603; LCSC C23212
R8: 33k; R0603; LCSC C4216
R9: Jumper-Pad-Pad; PAD-0805-PAD; LCSC C17477
R31, R32, R33: 10k; R0805; LCSC C17414
R41, R42: 2.7K; R0805; LCSC C17414
R43: 10K; R0805; LCSC C17414
USB1: Conn_01x04_Pin; JST_PH_B4B-PH-K_1x04_P2.00mm_Vertical; LCSC C265289
İŞLEMC1: Module:mega-mcu100/0.3; mega-mcu100

Connections:
+3.3V: İŞLEMC1.N21 (V33)
+3.3VA: İŞLEMC1.N15 (V33_SWITCHABLE)
+5V: J1.1, M1.E4 (V5), M1.V4 (5VP), İŞLEMC1.N22 (VCC)
+5VA: BLUETOOTH1.4, J2.18, M4.E4 (V5_IN), R31.2, R32.2, R33.2, R41.1, R42.1, İŞLEMC1.E1 (V5A_SWITCHABLE), İŞLEMC1.W2 (V5A_SWITCHABLE); also elsewhere on the board
+12V: F2.1, R8.2, R43.1
+12V_RAW: F2.2, J1.8, M1.V1 (V12_PERM), M1.V2 (IN_VIGN), M1.V3 (V12_RAW)
/ANALOG 1: J1.9, İŞLEMC1.S18 (IN_TPS_(PA4))
/ANALOG 2: J1.17, İŞLEMC1.S19 (IN_PPS_(PA3))
/ANALOG 3: J2.9, İŞLEMC1.S11 (IN_O2S_/_CAN_WAKEUP_(PA0))
/ANALOG 4: J2.10, İŞLEMC1.S10 (IN_O2S2_(PA1))
/ANALOG 5: J2.11, İŞLEMC1.S13 (IN_MAP1_(PC0))
/ANALOG 6: J2.12, İŞLEMC1.S9 (IN_AUX1_(PB0))
/ANALOG 7: J2.13, İŞLEMC1.S8 (IN_AUX2_(PC4/PE9))
/ANALOG 8: J2.14, İŞLEMC1.S7 (IN_AUX3_(PA7))
/AUX GROUP 1/IN1: İŞLEMC1.W4 (IGN7_(PB9)); also elsewhere on the board
/AUX GROUP 1/IN2: İŞLEMC1.W3 (IGN8_(PE6)); also elsewhere on the board
/AUX GROUP 2/IN1: İŞLEMC1.E11 (OUT_INJ7_(PD15)); also elsewhere on the board
/AUX GROUP 2/IN2: İŞLEMC1.E10 (OUT_INJ8_(PD12)); also elsewhere on the board
/AUX GROUP 3/IN1: İŞLEMC1.E18 (OUT_PWM1_(PD13)); also elsewhere on the board
/AUX GROUP 3/IN2: İŞLEMC1.E19 (OUT_PWM2_(PC6)); also elsewhere on the board
/BOBIN/IN1: İŞLEMC1.W10 (IGN1_(PC13)); also elsewhere on the board
/BOBIN/IN2: İŞLEMC1.W9 (IGN2_(PE5)); also elsewhere on the board
/BOBIN/IN3: İŞLEMC1.W8 (IGN3_(PE4)); also elsewhere on the board
/BOBIN/IN4: İŞLEMC1.W7 (IGN4_(PE3)); also elsewhere on the board
/BOBİN 1: J1.2; also elsewhere on the board
/BOBİN 2: J1.3; also elsewhere on the board
/BOBİN 3: J1.4; also elsewhere on the board
/BOBİN 4: J1.5; also elsewhere on the board
/BT_RX: BLUETOOTH1.2, J2.16, İŞLEMC1.N14 (UART2_RX_(PD6))
/BT_TX: BLUETOOTH1.1, J2.17, İŞLEMC1.N13 (UART2_TX_(PD5))
/CAN1+: J2.7, İŞLEMC1.W11 (CANH)
/CAN1-: J2.8, İŞLEMC1.W12 (CANL)
/ENJEKTOR/IN1: İŞLEMC1.E17 (OUT_INJ1_(PD3)); also elsewhere on the board
/ENJEKTOR/IN2: İŞLEMC1.E16 (OUT_INJ2_(PA9)); also elsewhere on the board
/ENJEKTOR/IN3: İŞLEMC1.E15 (OUT_INJ3_(PD11)); also elsewhere on the board
/ENJEKTOR/IN4: İŞLEMC1.E14 (OUT_INJ4_(PD10)); also elsewhere on the board
/ENJEKTÖR 1: J1.10; also elsewhere on the board
/ENJEKTÖR 2: J1.11; also elsewhere on the board
/ENJEKTÖR 3: J1.12; also elsewhere on the board
/ENJEKTÖR 4: J1.13; also elsewhere on the board
/INTERNAL_MAP: İŞLEMC1.S12 (IN_MAP2_(PC1)); also elsewhere on the board
/IN_BUTTON1: J2.4, R31.1, İŞLEMC1.S14 (IN_CRANK_(PB1))
/IN_BUTTON2: J2.5, R32.1, İŞLEMC1.S16 (IN_CAM_(PA6))
/IN_BUTTON3: J2.6, R33.1, İŞLEMC1.S1 (IN_D4_(PE15))
/IN_CLT: J1.14, R42.2, İŞLEMC1.S21 (IN_CLT_(PC2))
/IN_HALL1: J1.23, İŞLEMC1.S4 (IN_D1_(PE12))
/IN_HALL2: J2.1, İŞLEMC1.S3 (IN_D2_(PE13))
/IN_HALL3: J2.2, İŞLEMC1.S2 (IN_D3_(PE14))
/IN_HALL4: J2.3, İŞLEMC1.S17 (IN_VSS_(PE11))
/IN_IAT: J1.15, R41.2, İŞLEMC1.S20 (IN_IAT_(PC3))
/IN_VMAIN: R7.2, R8.1, İŞLEMC1.S6 (IN_AUX4_(PC5))
/PG_5VP: R9.2, İŞLEMC1.N12 (SPI3_MOSI_(PC12))
/PWR_EN: M1.E5 (EN_5VP), İŞLEMC1.N20 (OUT_PWR_EN_(PE10))
/USB+: USB1.2, İŞLEMC1.N3 (USBP_(PA12))
/USB-: USB1.3, İŞLEMC1.N2 (USBM_(PA11))
/VBAT: M1.E1 (VBAT), İŞLEMC1.N17 (VBAT)
/VBUS: USB1.4, İŞLEMC1.N1 (VBUS)
/VIGN: M1.E3 (VIGN), İŞLEMC1.E5 (IN_VIGN_(PA5))
/VREF1: İŞLEMC1.S22 (VREF1)
/VR_MAX9924: M4.E3 (OUT), İŞLEMC1.N19 (UART8_TX_(PE1))
/VR_MAX9924+: J1.6, M4.W2 (VR+)
/VR_MAX9924-: J1.7, M4.W1 (VR-)
/ÇIKIŞ 1: J1.18, R43.2; also elsewhere on the board
/ÇIKIŞ 2: J1.19; also elsewhere on the board
/ÇIKIŞ 3: J1.20; also elsewhere on the board
/ÇIKIŞ 4: J1.21; also elsewhere on the board
/ÇIKIŞ 5: J1.22; also elsewhere on the board
/ÇIKIŞ 6: J2.15; also elsewhere on the board
GND: BLUETOOTH1.3, J1.24, J2.19, J2.20, M1.S1 (GND), M4.G (GND), R7.1, USB1.1, İŞLEMC1.G (GND); also elsewhere on the board
GNDA: J1.16, İŞLEMC1.W1 (GNDA)
unnamed: M1.E6 (PG_5VP), R9.1

Notes on the sheet:
Direnci konum R143'ten R145'e taşıyın CAN WAKEUP fonksiyonunu etkinleştirin. AUX1 analog girişi kullanılamaz olacaktır.
Configurable "BUTTON" pulls

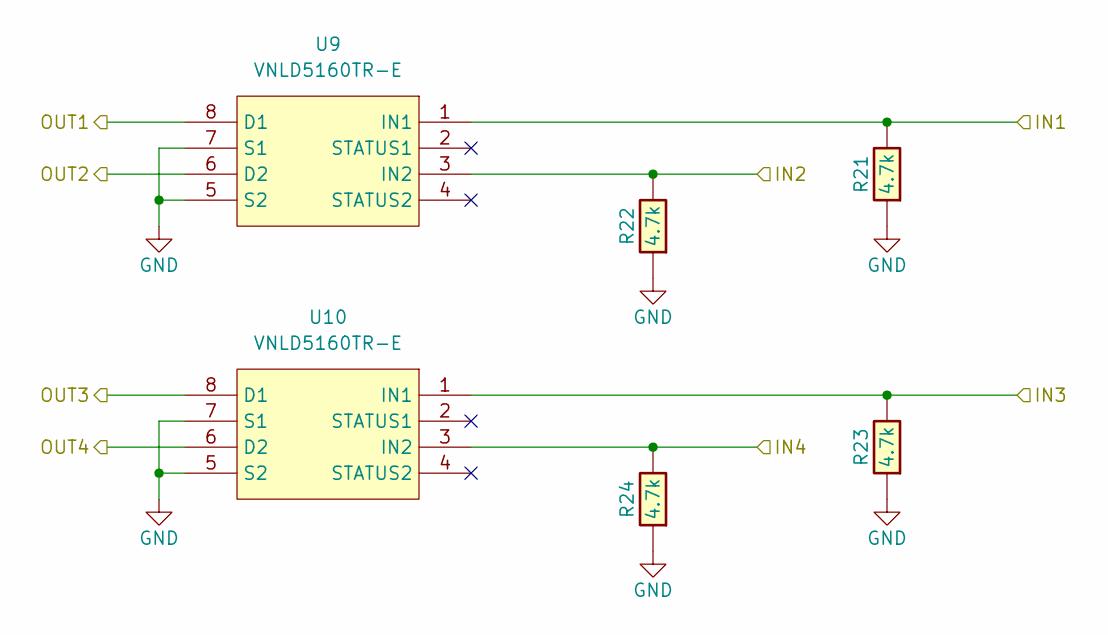
[picture p124: schematic INJ6.kicad_sch, UAEFI]

Parts:
R21, R22, R23, R24: 4.7k; R0603; LCSC C23162
U9, U10: VNLD5160TR-E; SOIC-8_3.9x4.9mm_P1.27mm; LCSC C377942

Connections:
/ENJEKTOR/IN1: R21.2, U9.1 (IN1); also elsewhere on the board
/ENJEKTOR/IN2: R22.2, U9.3 (IN2); also elsewhere on the board
/ENJEKTOR/IN3: R23.2, U10.1 (IN1); also elsewhere on the board
/ENJEKTOR/IN4: R24.2, U10.3 (IN2); also elsewhere on the board
/ENJEKTÖR 1: U9.8 (D1); also elsewhere on the board
/ENJEKTÖR 2: U9.6 (D2); also elsewhere on the board
/ENJEKTÖR 3: U10.8 (D1); also elsewhere on the board
/ENJEKTÖR 4: U10.6 (D2); also elsewhere on the board
GND: R21.1, R22.1, R23.1, R24.1, U9.5 (S2), U9.7 (S1), U10.5 (S2), U10.7 (S1); also elsewhere on the board

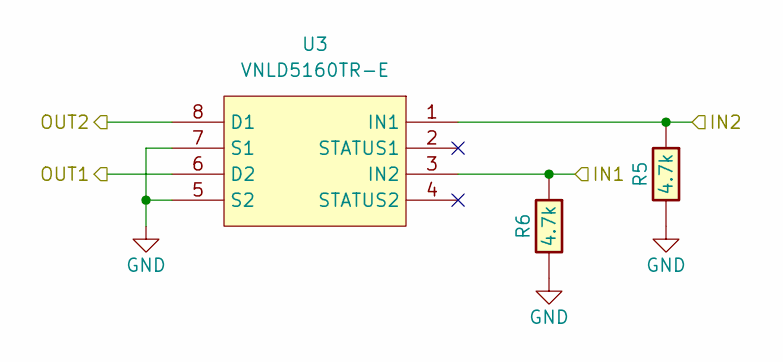
[picture p125: schematic LS_HOT.kicad_sch, UAEFI]

Parts:
R5, R6: 4.7k; R0603; LCSC C23162
U3: VNLD5160TR-E; SOIC-8_3.9x4.9mm_P1.27mm; LCSC C377942

Connections:
/AUX GROUP 3/IN1: R6.1, U3.3 (IN2); also elsewhere on the board
/AUX GROUP 3/IN2: R5.1, U3.1 (IN1); also elsewhere on the board
/ÇIKIŞ 5: U3.6 (D2); also elsewhere on the board
/ÇIKIŞ 6: U3.8 (D1); also elsewhere on the board
GND: R5.2, R6.2, U3.5 (S2), U3.7 (S1); also elsewhere on the board

Parts of its further copies:
R1, R2, R3, R4: 4.7k; R0603; LCSC C23162
U1, U2: VNLD5160TR-E; SOIC-8_3.9x4.9mm_P1.27mm; LCSC C377942

Connections of its further copies:
/AUX GROUP 1/IN1: R2.1, U1.3 (IN2); also elsewhere on the board
/AUX GROUP 1/IN2: R1.1, U1.1 (IN1); also elsewhere on the board
/AUX GROUP 2/IN1: R4.1, U2.3 (IN2); also elsewhere on the board
/AUX GROUP 2/IN2: R3.1, U2.1 (IN1); also elsewhere on the board
/ÇIKIŞ 1: U1.6 (D2); also elsewhere on the board
/ÇIKIŞ 2: U1.8 (D1); also elsewhere on the board
/ÇIKIŞ 3: U2.6 (D2); also elsewhere on the board
/ÇIKIŞ 4: U2.8 (D1); also elsewhere on the board
GND: R1.2, R2.2, R3.2, R4.2, U1.5 (S2), U1.7 (S1), U2.5 (S2), U2.7 (S1); also elsewhere on the board

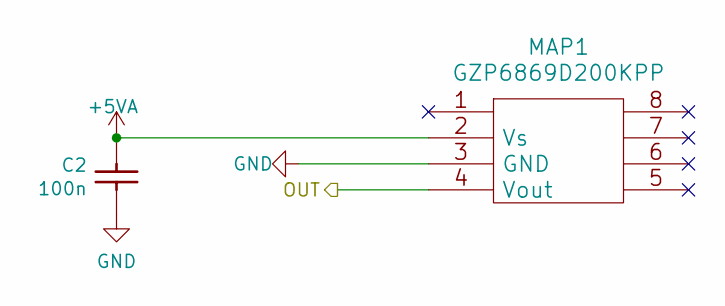
[picture p126: schematic MAP.kicad_sch, UAEFI]

Parts:
C2: 100n; C0603; LCSC C14663
MAP1: GZP6869D200KPP; MPXH6400A-SSOP8; LCSC C3038053

Connections:
+5VA: MAP1.2 (Vs); also elsewhere on the board
/INTERNAL_MAP: MAP1.4 (Vout); also elsewhere on the board
GND: MAP1.3 (GND); also elsewhere on the board

Parts of its further copies:
C1: 100n; C0603; LCSC C14663

Connections of its further copies:
+5VA: C1.2; also elsewhere on the board
GND: C1.1; also elsewhere on the board

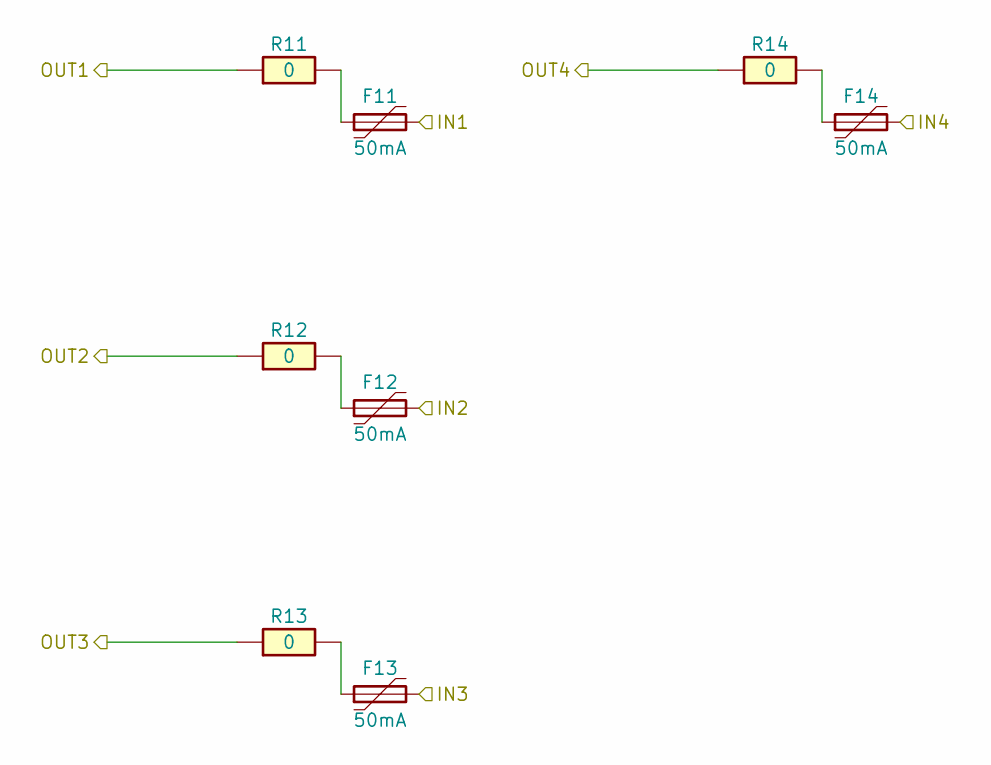
[picture p127: schematic IGN6.kicad_sch, UAEFI]

Parts:
F11, F12, F13, F14: 50mA; Fuse_0603_1608Metric; LCSC C369141
R11, R12, R13, R14: 0; R0603; LCSC C21189

Connections:
/BOBIN/IN1: F11.2; also elsewhere on the board
/BOBIN/IN2: F12.2; also elsewhere on the board
/BOBIN/IN3: F13.2; also elsewhere on the board
/BOBIN/IN4: F14.2; also elsewhere on the board
/BOBİN 1: R11.1; also elsewhere on the board
/BOBİN 2: R12.1; also elsewhere on the board
/BOBİN 3: R13.1; also elsewhere on the board
/BOBİN 4: R14.1; also elsewhere on the board
unnamed: F11.1, R11.2
unnamed: F12.1, R12.2
unnamed: F13.1, R13.2
unnamed: F14.1, R14.2

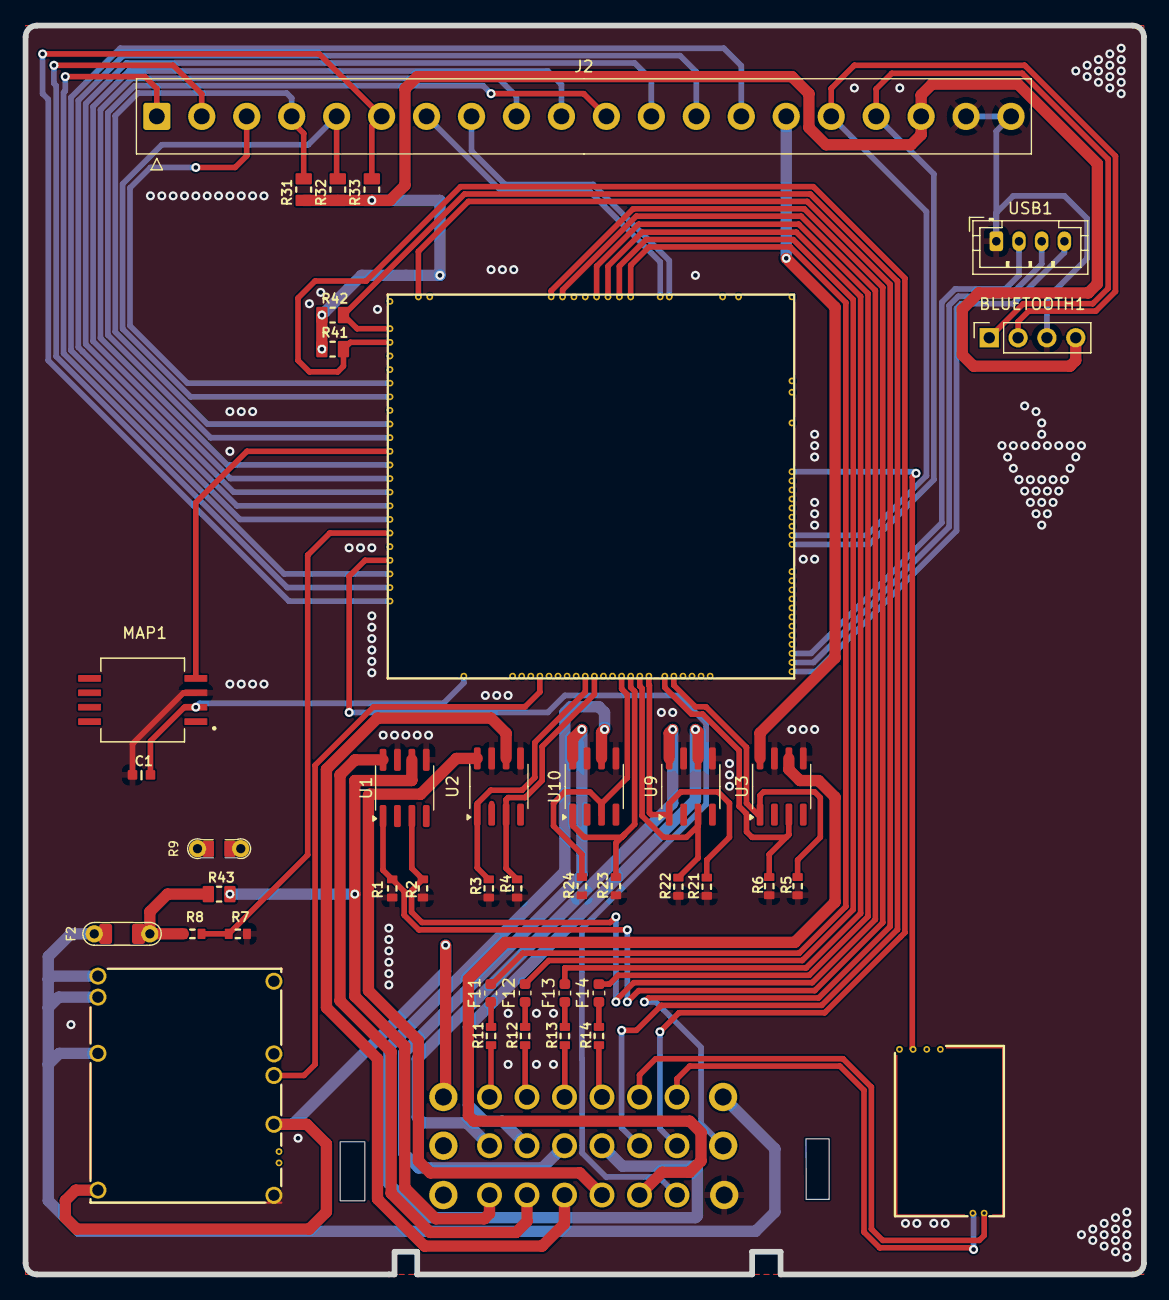
[picture p128: board stabildaytona.kicad_pcb from above]

Board: 4 copper layers, 98.5 x 110.0 mm, 42 parts (0 on the bottom side), 72 nets.
