ozeromer1111/hellen-example/(commit log)

2024-12-31 v1
    stabil daytona v1
    [022035055.stp, 039301060.stp, 039301080.stp, 039301160.stp, 039301180.stp, 039301200.stp, 1054500101.stp, DC_MOTOR_0.1.kicad_sch]
2025-01-02 v1 test
    test
    [stabil-daytona-B_Cu.gbl, stabil-daytona-B_Cu.gbr, stabil-daytona-B_Mask.gbr, stabil-daytona-B_Mask.gbs, stabil-daytona-B_Paste.gbp, stabil-daytona-B_Paste.gbr, stabil-daytona-B_Silkscreen.gbo, stabil-daytona-B_Silkscreen.gbr]
2025-01-02 test v2
    v2
    [stabil-daytona.kicad_pcb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]
2025-01-02 [skip actions] Auto-generated board v2.1
    [stabildaytona-B_Cu.gbl, stabildaytona-B_Mask.gbs, stabildaytona-B_Paste.gbp, stabildaytona-B_Silkscreen.gbo, stabildaytona-Edge_Cuts.gm1, stabildaytona-F_Cu.gtl, stabildaytona-F_Mask.gts, stabildaytona-F_Paste.gtp]
2025-01-02 test v4
    [bom_replace_stabildaytona-v1.csv]
2025-01-03 v1 tam test
    [daytona-BOM.csv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]
2025-01-31 GHA says update kicad6-libraries
2025-04-19 stabil jr.
    [IGN6.kicad_sch, INJ6.kicad_sch, LS_HOT.kicad_sch, MAP.kicad_sch, bom_replace_stabildaytona-v1.csv, stabildaytona.kicad_pcb, stabildaytona.kicad_sch]
